xiaoqing1993/ECSE548_viterbi_decoder/README.md

# ECSE548_viterbi_decoder
The repository of final project, for codes and electric files updating and exchanging
