xiaoqing1993/ECSE548_viterbi_decoder/Final Project presentation.pptx

## (8,4,4) Viterbi Decoder

Group 2: Harsh Aurora, Adam Cavatassi, Xiaoqing Ma, Dylan Watts

## Overview

- Background
  - Encoding, transmission and decoding basics.
  - Overview of the Viterbi (8,4,4) trellis.
- Schematic and Layout
  - Design overview of key modules.
  - Implementation in schematic and layouts.
- Testing
  - Propagation Delay
  - Power
- Summary of Major Work
- Future Work
- References

## Background

Harsh Aurora

## Simplified Transmission Model

Transmitter

Encoder

Message bits + error control

[10110010]

Channel

Receiver

Decoder

Message recovery

[10X10X10]

Information Source

Output message bits

[1011]

Modulator

Transmission
pulses

Demodulator

Pulse sampling

Information Sink

Input message bits

[1011]

Gaussian Noise Corruption

[1.3, 0.1, 0.5, 1.8, -0.2, 0.5, 0.9, 0.1]

## Hamming (8,4,4) Encoder

Generator Matrix:
G= [1, 0, 0, 0, 1, 1, 1, 00, 1, 0, 0, 1, 1, 0, 10, 0, 1, 0, 1, 0, 1, 10, 0, 0, 1, 0, 1, 1, 1]
⟹ c= mG
m= m_0 m_1 m_2 m_3
c= c_0 c_1 c_2 c_3 c_4 c_5 c_6 c_7
c= m_0 m_1 m_2 m_3 p_0 p_1 p_2 p_3

- Message: m_0 m_1 m_2 m_3
- Codeword: c_0 =m_0
- c_1 =m_1
- c_2 =m_2
- c_3 =m_3
- c_4 =m_0 ⊕m_1 ⊕m_2
- c_5 =m_0 ⊕m_1 ⊕m_3
- c_6 =m_0 ⊕m_2 ⊕m_3
- c_7 =m_1 ⊕m_2 ⊕m_3

## Hamming (8,4,4) Encoder: Optimized Trellis

m_0 m_1 /m_0 m_1

m_0 m_1

00

m_2 /m_2 p_0

p_2 p_3

00

m_3 /m_3 p_1

p_2 p_3

00

- /p_2 p_3

0/00

0/00

00/00

1/11

1/11

1/11

1/11

-/00

Start

11/11

11

0/00

11

0/00

11

-/11

End

Example: m=0101

10

0/01

10

0/01

10

-/10

01/01

10/10

⟹ c=01011010

-/01

01

1/10

1/10

01

1/10

1/10

01

0/01

0/01

## Modulator and Channel

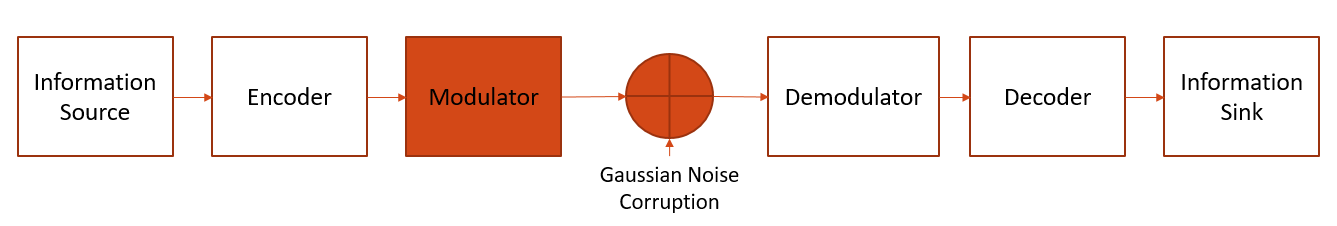
[picture p1: figure]

Channel:
- Source of noise, characterized by Signal to Noise ratio (SNR)
- SNR= (E_b)/(N_o) dB
where E_b =Energy per bit, andN_o =Noise spectral density
- Generate Gaussian distributed noise samples n= n_0 n_1 n_2 n_3 n_4 n_5 n_6 n_7
Change the variance of the Gaussian to achieve different (E_b)/(N_o)
- The noisy channel observation r is computed using
r= x+n

BPSK modulation scheme:
- 0=−1/2
- 1= 1/2
Using this scheme, Codeword c is modulated to the channel input x

## Slide 8

Hamming (8,4,4)
Decoder

Aim: Retrieve the sent message m , given the noisy channel observation r= r_0 r_1 r_2 r_3 r_4 r_5 r_6 r_7

Maximum Likelihood decoder (MLE)
- Best decoding performance!
- Generate the codebook
All possible codewords for the 2⁴ unique messages
- Compute the distance between r and each codeword
- Most probable transmitted codeword = min‖‖r −c_i ‖‖
For all c_i in the codebook
- Computationally intensive!
(≈ 383 flops)

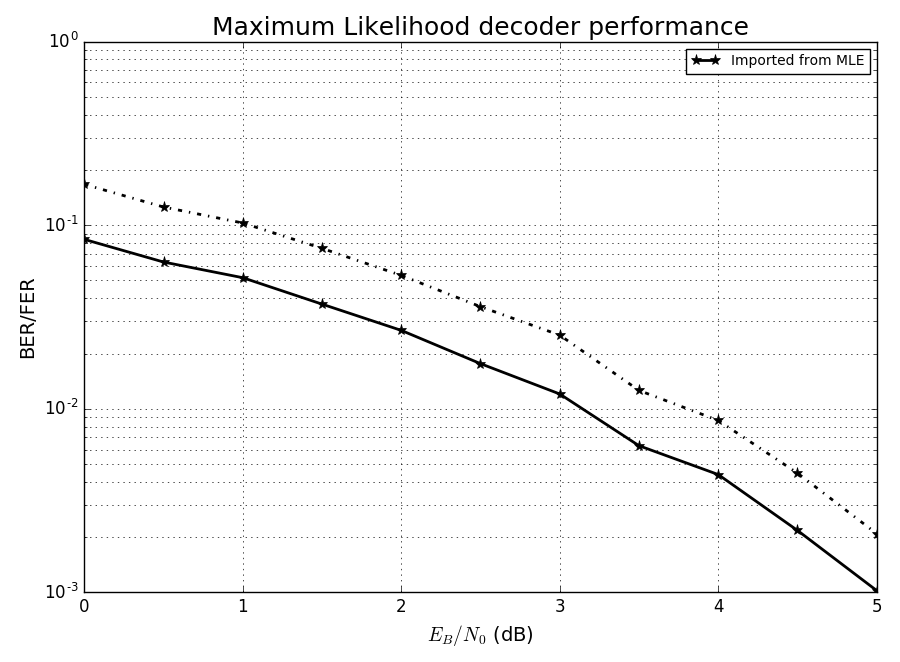
[picture p2: figure]

Figure 1: Maximum likelihood decoder performance.

## Slide 9

Hamming (8,4,4)
Decoder

Viterbi Decoder
- Same performance as the MLE decoder!
- Uses the Viterbi Algorithm on the Trellis
Calculate the shortest path of r through the Trellis
- The most likely m is extracted from the shortest path
- The modulation scheme and symmetry of the Trellis can further reduce the number of computations
(≈ 27 flops)

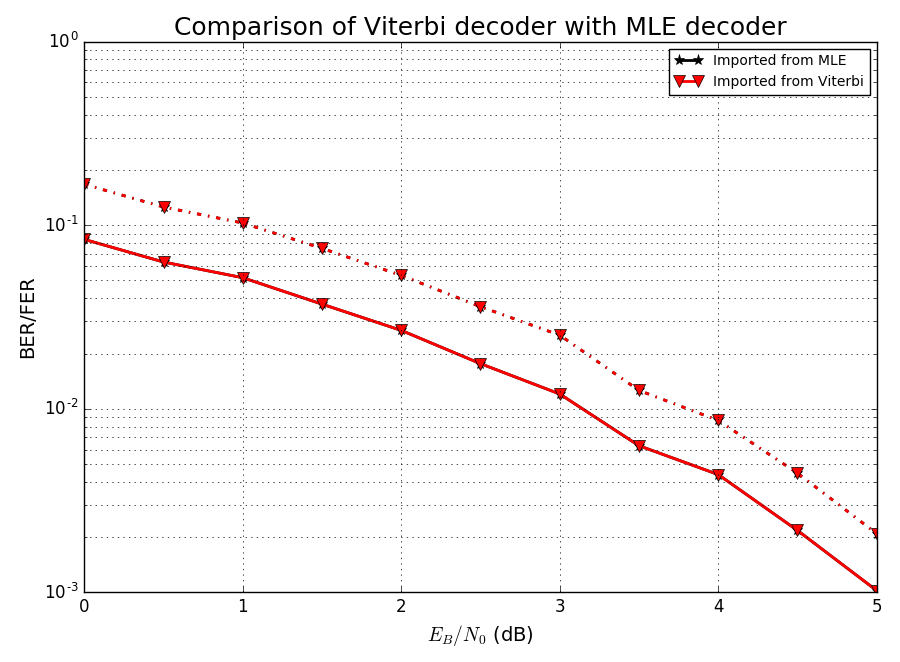
[picture p3: figure]

Figure 2: Comparison of Viterbi decoder with MLE decoder.

## Slide 10

Hamming (8,4,4)
Decoder

(−1)/2 (−1)/2

r_2 +r_4

(−1)/2 (−1)/2

r_3 +r_5

(−1)/2 (−1)/2

r_0 +r_1

1/2 1/2

0

0

1/2 1/2

0

0

1/2 1/2

r_6 +r_7

Start

0

r_2 +r_4

r_3 +r_5

0

End

r_1

1/2 (−1)/2

r_2

1/2 (−1)/2

r_3

1/2 (−1)/2

r_6

r_0

r_4

r_4

r_5

r_5

r_7

(−1)/2 1/2

r_2

(−1)/2 1/2

r_3

(−1)/2 1/2

Figure 3: Example of Hamming (8,4,4) trellis decoder.

## Slide 11

Hamming (8,4,4)
Decoder

Preparing for hardware: Use fixed point arithmetic for floating point operations!
- An approximation of a floating point number
Represent a signed floating point number f as an ( n+m ) bit binary number b= b_(n−1) ⋯b_0 b_(−1) ⋯b_(−m)
- Define the fixed point format Qn.m, where
f= −2^(n−1) b_(n−1) +2^(n−2) b_(n−2) +⋯+2^0 b_0 +2^(−1) b_(−1) +⋯+2^(−m) b_(−m)
- Fixed point arithmetic is implemented in the same manner as 2’s complement arithmetic
With the exception that an overflow/underflow is handled by saturating the result at the maximum/minimum value of the Qn.m format
- Fixed point arithmetic inherently produces quantization noise into the floating point calculations!

## Slide 12

Hamming (8,4,4)
Decoder

Obtain the performance of the Viterbi decoder for different Qn.m formats

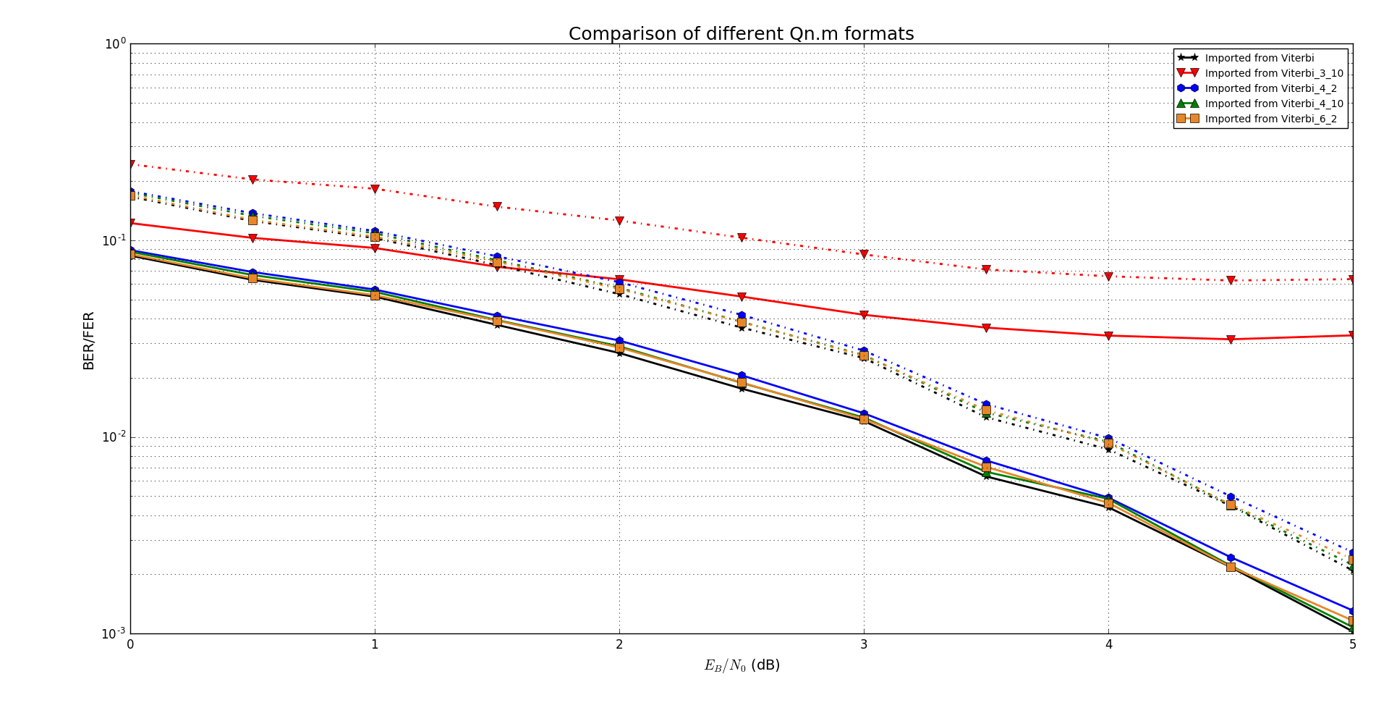
[picture p4: figure]
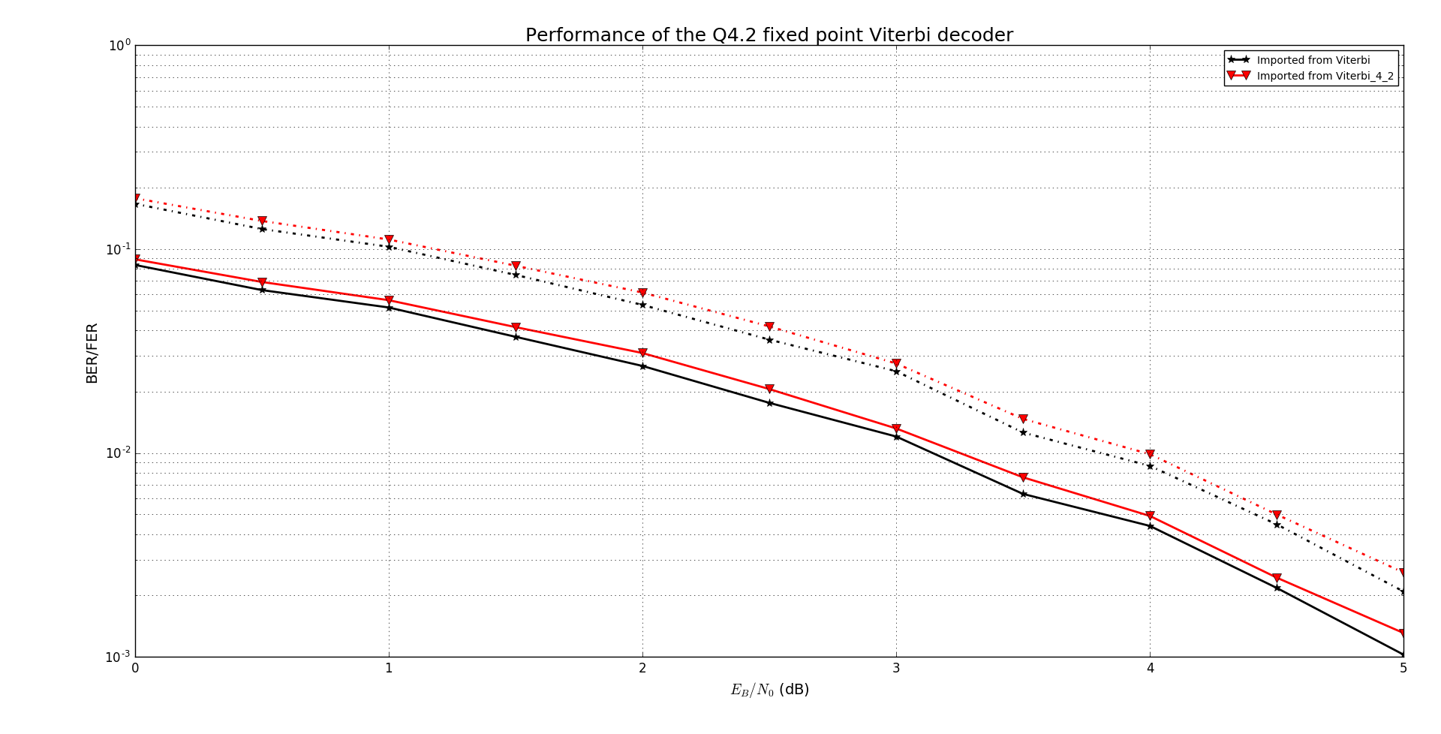
[picture p5: figure]

Figure 4: Performance of various fixed point lengths

- Q3.10
Not enough integer range
- Q4.2
Slight quantization noise
- Q4.10
Greater fractional precision reduces noise, but at high cost (8 bits in this case)
- Q6.2
Marginal improvements for greater integer range

## Schematic and Layout

Adam Cavatassi, Xiaoqing Ma

## Design Summary

- AMI 0.5μm process
- MOSIS scalable CMOS submicron design rules
- λ = 0.3μm

## Design Goals

- Schematics and layout of 2 viterbi decoder
  - Optimized for speed and power respectively
- Schematics and layouts of related modules
- DRC ERC NCC

## Required Modules

- 6-bit Adder
  - Optimization for Speed: Kogge-Stone Adder
  - Optimization for Power: Carry-Ripple Adder
- 6-bit Signed Number Comparator
- 6-bit Multiplexer

## Adder

- 6-bit signed binary addition
  - If result < -32 (10000), output result as -32
  - If result > 31 (01111), output result as 31
- Overflow
  - Check whether the result is out of range [-32, 31]

## Carry-Ripple Adder

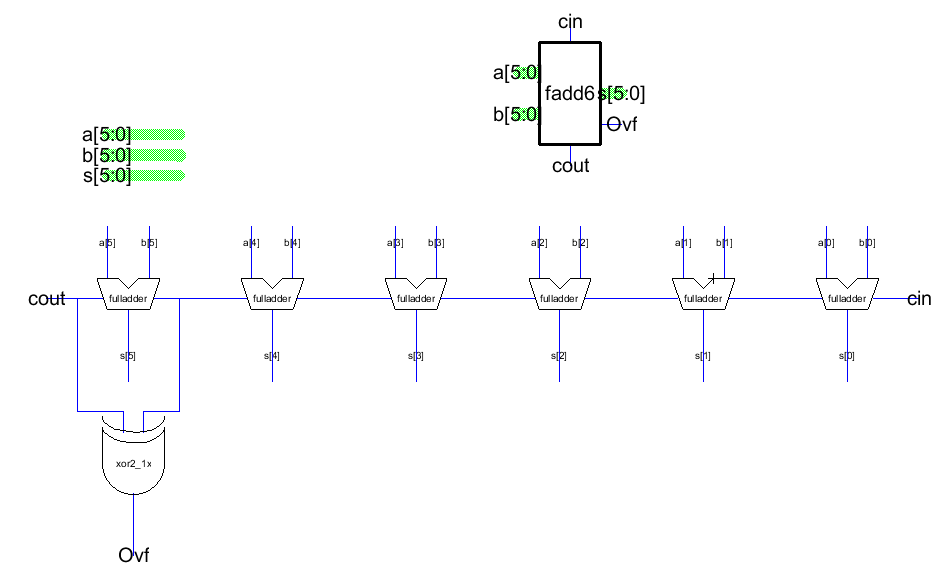
[picture p6: figure]

Figure 5: Schematic and layout of 6-bit carry-ripple adder

## Carry-Ripple Adder

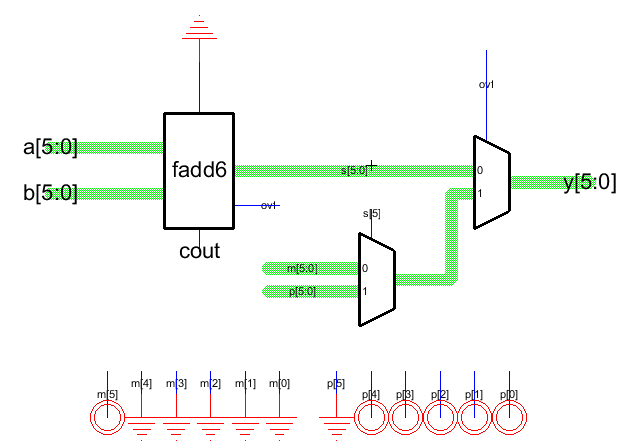
[picture p7: figure]
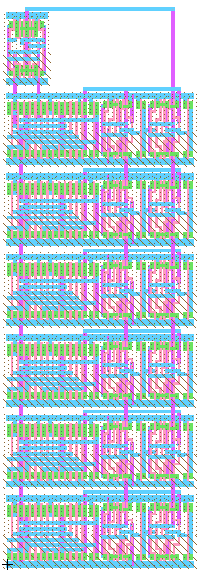
[picture p8: figure]

Figure 6: Schematic and layout of 6-bit carry-ripple adder

## Kogge-Stone (Tree Adder) – General Diagram

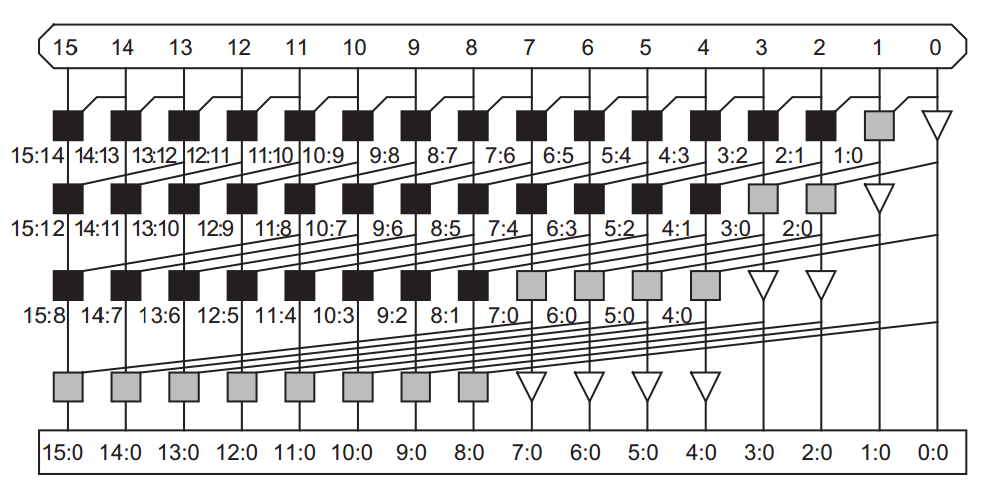
[picture p9: figure]

Figure 7 Reproduced from [1]: 16-bit kogge-stone adder PG networks

## Kogge-Stone (Tree Adder) – Bitwise PG Logic

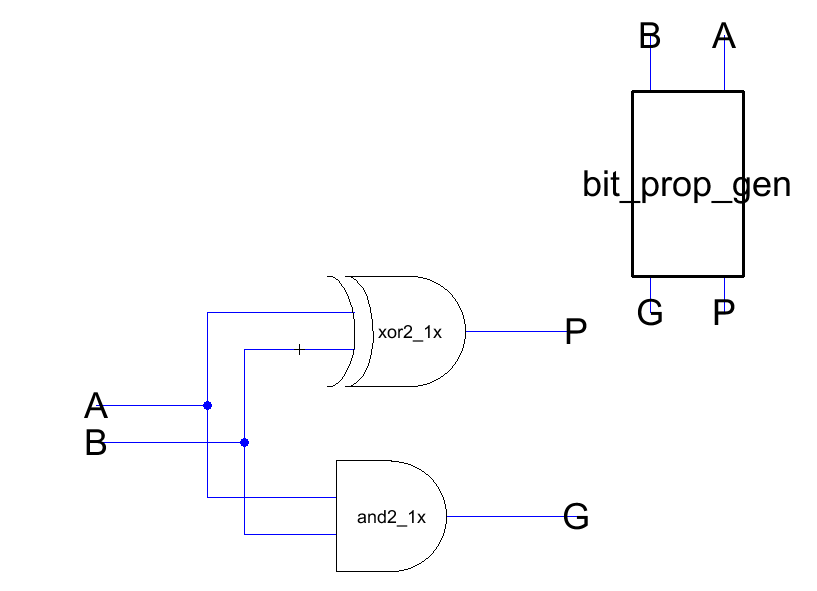
[picture p10: figure]
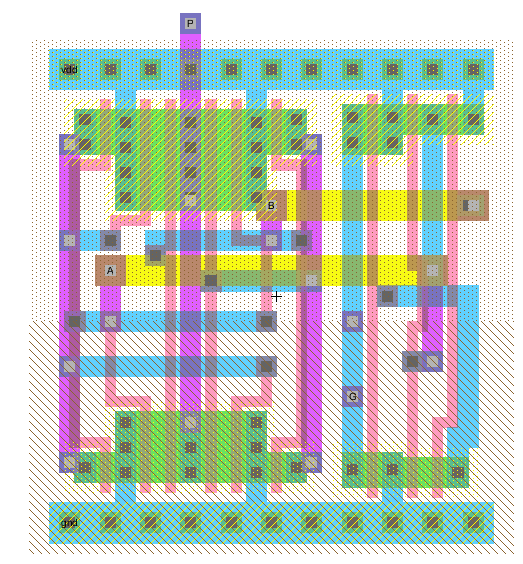
[picture p11: figure]

Figure 8: Schematic and layout of bitwise PG logic

## Kogge-Stone (Tree Adder) – Group PG Logic

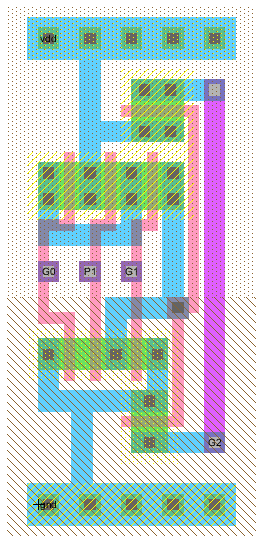
[picture p12: figure]
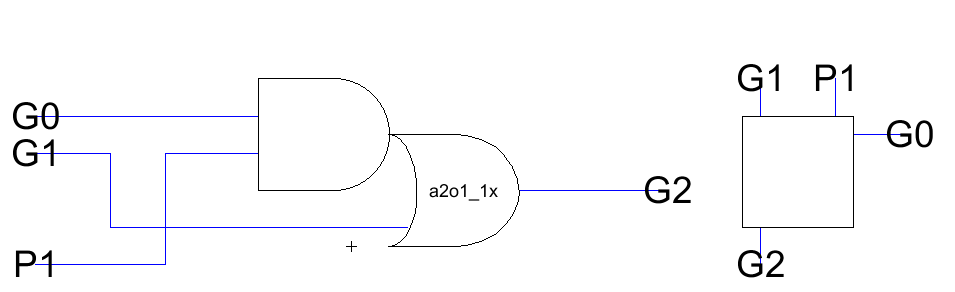
[picture p13: figure]

Figure 9: Schematic and layout of group PG logic (white cell)

## Kogge-Stone (Tree Adder) – Group PG Logic

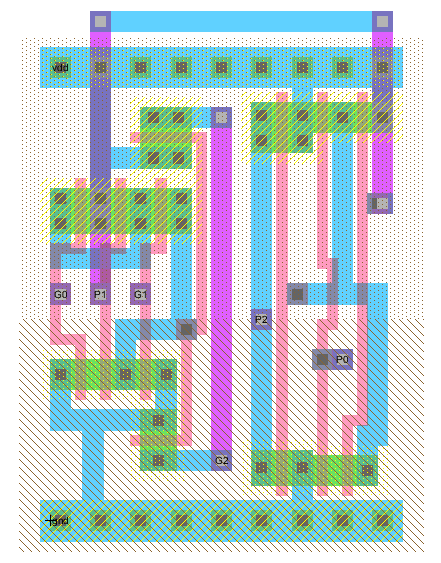
[picture p14: figure]
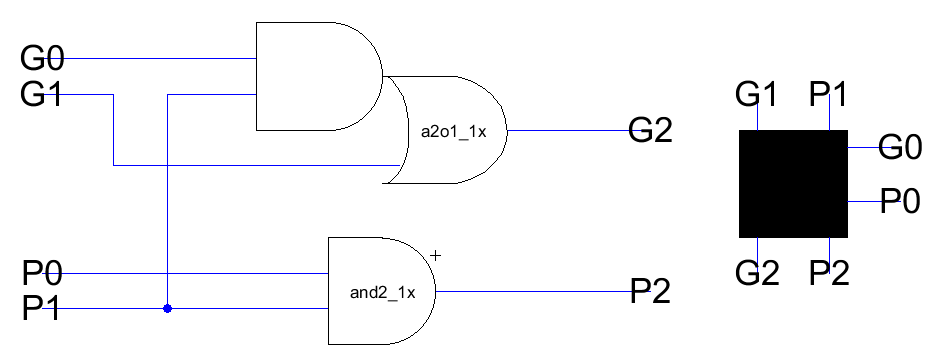
[picture p15: figure]

Figure 10: Schematic and layout of group PG logic (black cell)

## Kogge-Stone (Tree Adder) – Overall Design

Bitwise PG Logic

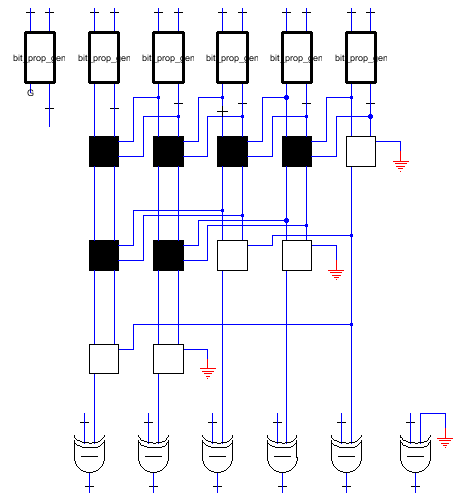
[picture p16: figure]
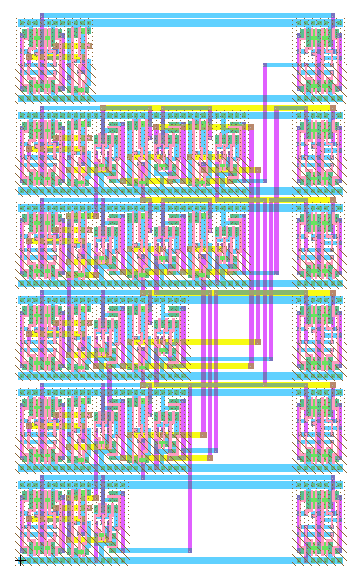
[picture p17: figure]

Rotate 90 Degrees Counterclockwise

Group PG Logic

Sum Logic

Figure 11: Schematic and layout of 6-bit kogge-stone adder

## Kogge-Stone (Tree Adder) – Overall Design

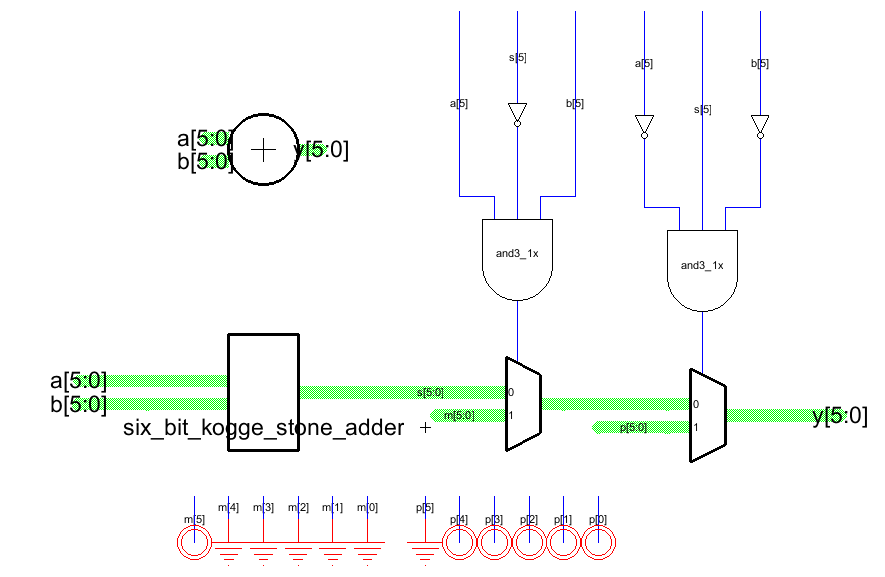
[picture p18: figure]
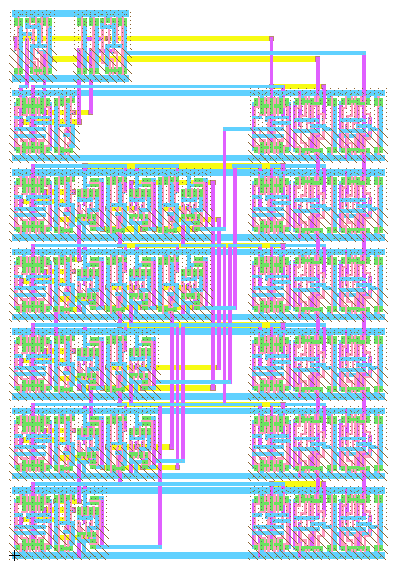
[picture p19: figure]

Figure 12: Schematic and layout of 6-bit kogge-stone adder

## Comparator - Components

- 6-bit Carry-Ripple Adder
- 6-bit Inverter
- 1-bit XOR

## Comparator – Schematic and Layout

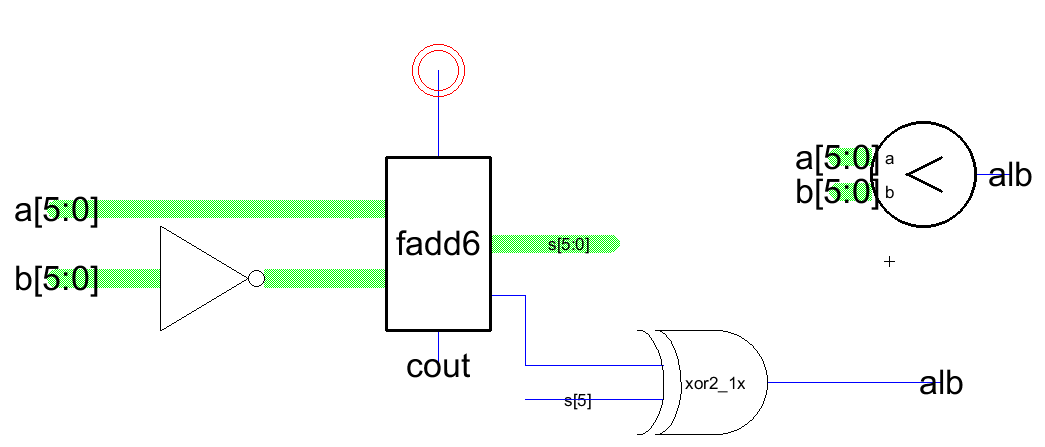
[picture p20: figure]

Figure 13: Schematic and layout of 6-bit comparator

## Miscellaneous

- 6-bit Multiplexer
  - Consist of 6 1-bit multiplexers
  - mux2_c_1x from standard cell library
- 6-bit Inverter
  - Consist of 6 1-bit inverters
  - Inv_1x from standard cell library

## Miscellaneous - 6-bit mux

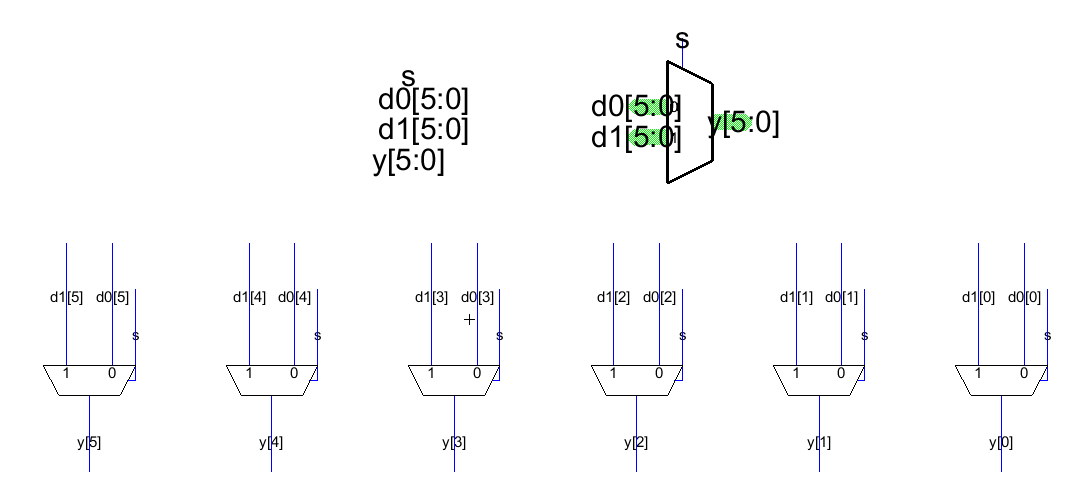
[picture p21: figure]

Figure 14: Schematic and layout of 6-bit mux

## Miscellaneous - 6-bit inverter

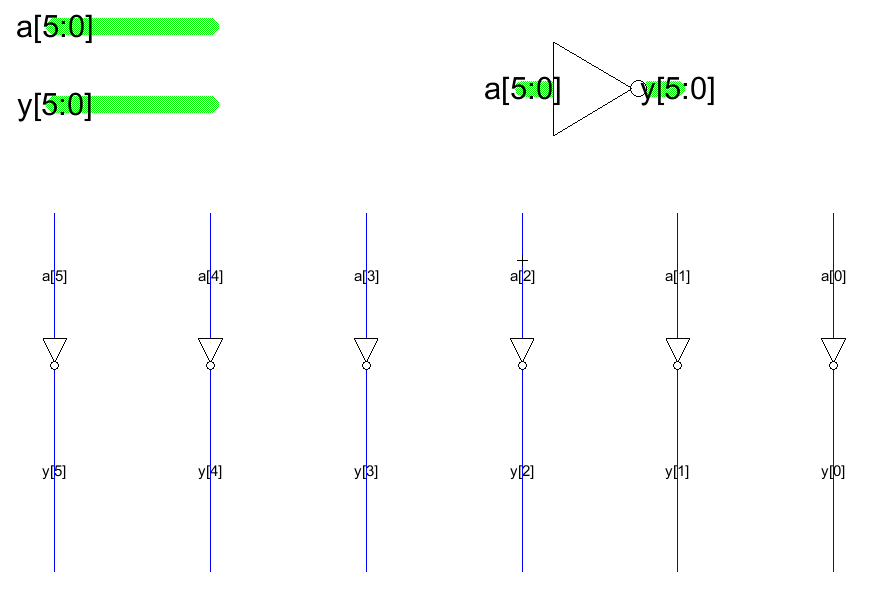
[picture p22: figure]

Figure 15: Schematic and layout of 6-bit inverter

## Overall Design – Components

Table 1: Number of individual modules

Module | Required Number
6-bit Adder | 18
6-bit Comparator | 11
6-bit Multiplexer | 10
1-bit Multiplexer | 12
1-bit Inverter | 6

## Overall Design - Schematic

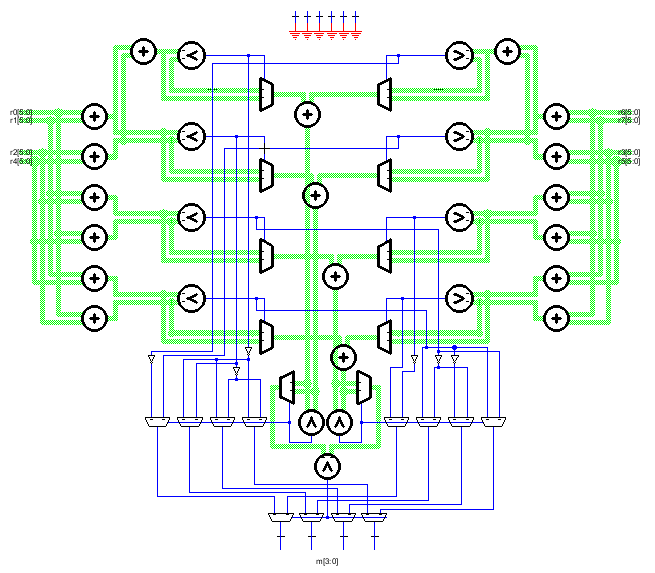
[picture p23: figure]

Figure 16: Schematic of Viterbi decoder

r0[5:0]

r1[5:0]

r7[5:0]

r6[5:0]

r4[5:0]

r2[5:0]

r3[5:0]

r5[5:0]

m[3:0]

## Overall Design – Layout (with CRA)

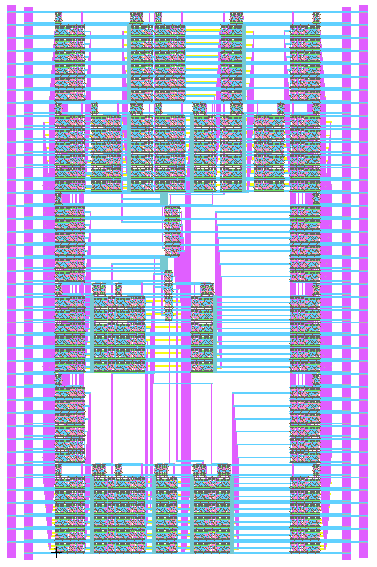
[picture p24: figure]

Figure 17: Layout of Viterbi decoder with carry-ripple adders

## Overall Design – Layout (with KSA)

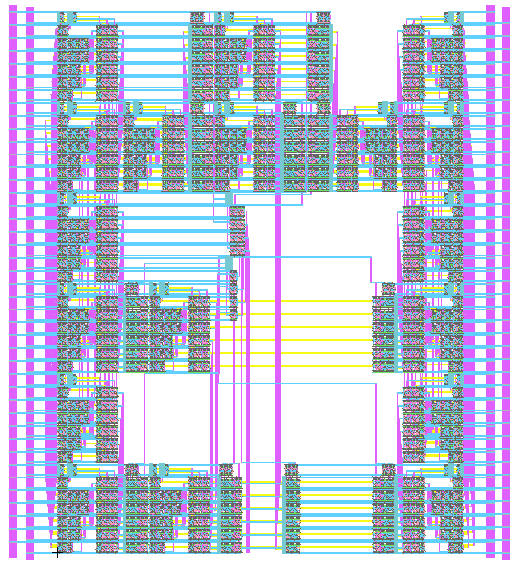
[picture p25: figure]

Figure 18: Layout of Viterbi decoder with kogge-stone adders

## Testing

Harsh Aurora, Dylan Watts

## Logic Simulators

Harsh Aurora

## ModelSim

Functional verification of hardware designed in Electric
  - Create a fixed point Viterbi Decoder in Verilog using ideal hardware components
  - Extract noisy channel observations in Q4.2 format and the expected output from C code
  - Build a testbench around the Verilog decoder implementation
Using the extracted data from the C code
  - Allow for incremental testing of hardware
Substitute ideal Verilog components with Verilog code extracted from Electric

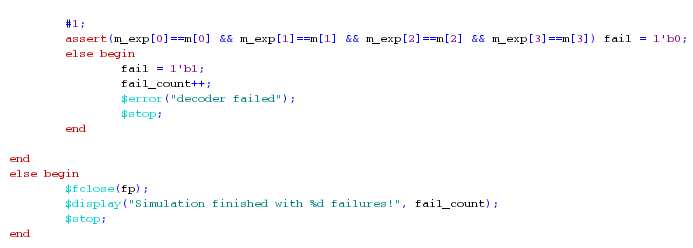
[picture p26: figure]

Figure 19: Example of functional testing via ModelSim

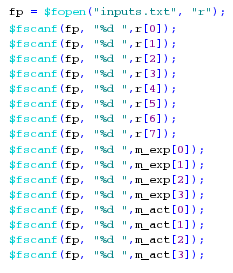
[picture p27: figure]

## Electric

- All schematics and layouts passed DRC, ERC, NCC, as well as functionality testing through ModelSim and IRSIM

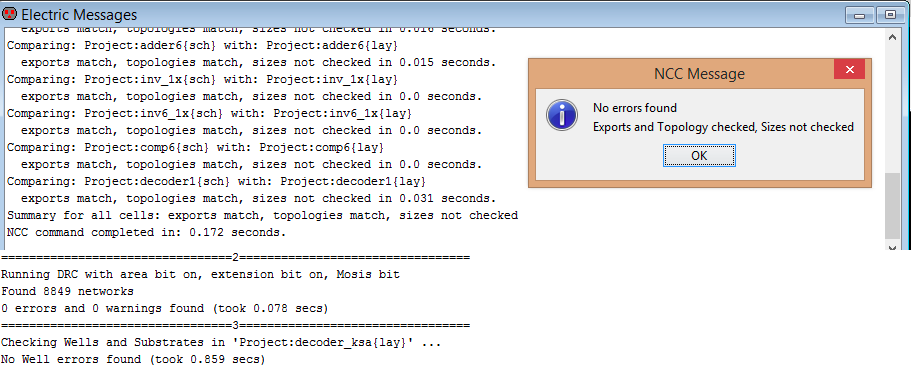
[picture p28: figure]

Figure 20: Demonstration of passing design checks for both decoder implementations.

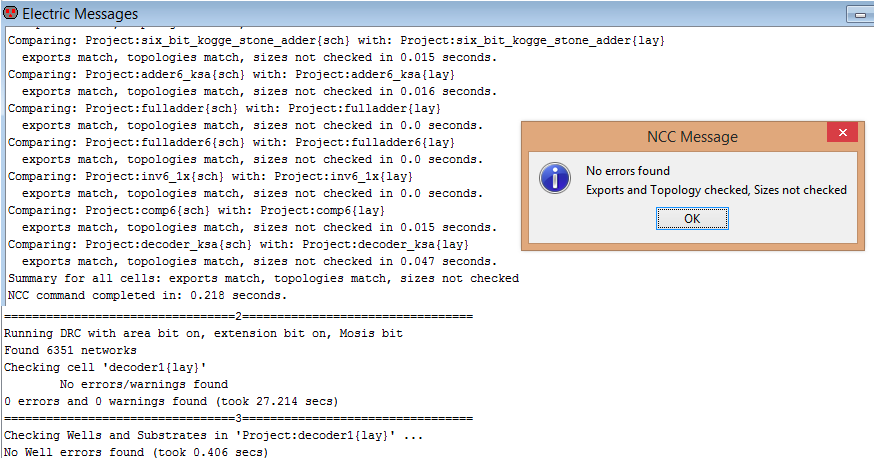
[picture p29: figure]

## Circuit Simulators

Dylan Watts

## Challenges and Assumptions

Challenges:
  - Circuit complexity – overall not a large circuit, but a lot of inputs.
  - Licensing!!!!
Assumptions:
  1. Assume uniform distribution of input vectors – not true in general, but conservative.
  2. Neglect static power dissipation due to size of process, assume switching power is dominant factor.
  3. For the purposes of power calculation, each module drives a “characteristic capacitive load” which is a weighted average of interconnect and input capacitance.
  4. Delay of all outputs equal to the largest propagation delay for multi-output modules.
  5. False paths are neglected.
  6. Interconnect is neglected
  7. The transistor are uniformly sized using the “1x” ratio (between 1.5-2.5).

## Power Analysis

8 inputs of 6 bits each – Possible combinations are 2⁴⁸ = 281 trillion!
  - Impractical to test all possible combinations of inputs and outputs in SPICE.
Can use a bounding approach.
  - Test all possible combinations of input vectors for individual modules and observe the power statistics
  - Min/avg/max power consumption.
Multiply individual statistics by the number of modules in the circuit.
By assuming every component in circuit is operating at the worst case input, can obtain a very conservative estimate of worst-case power consumption for the overall circuit.

## Power Analysis

Ripple-Carry and Kogge-Stone adder/comparator each take two six-bit input vectors:
  - 2¹² = 4096 possible input combinations.
2-input MUX takes two six-bit input vectors, 1 select line:
  - Since it’s one or the other, can simplify to 1 six-bit input vector and one select line.
  - 2⁷ = 128 possible input combinations.
Can generate these inputs intelligently by adding voltage pulses oscillating at specific frequencies:

## Power Analysis

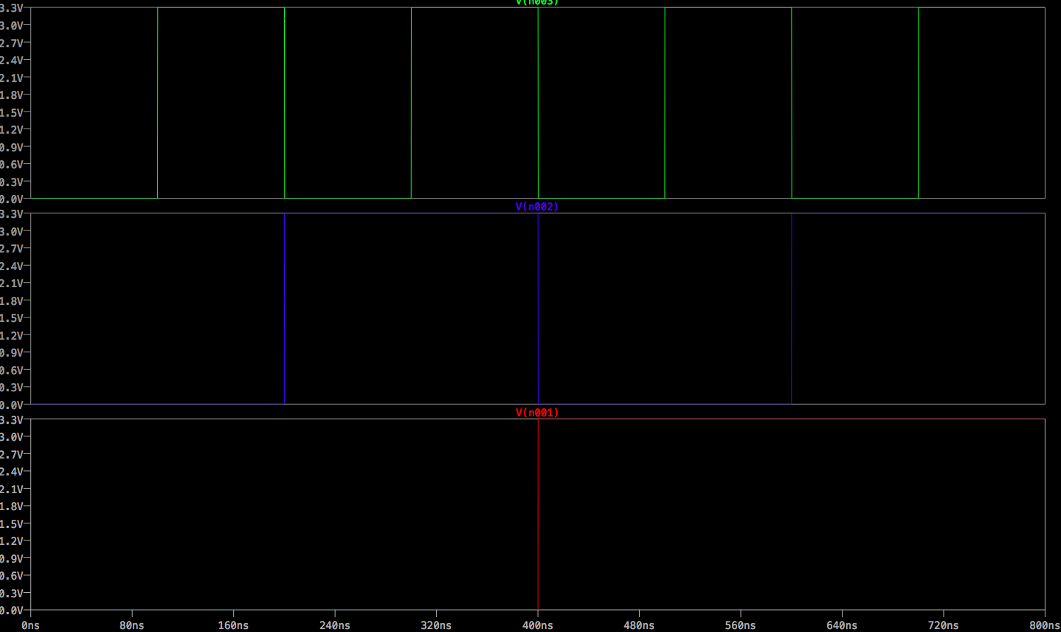
[picture p30: figure]

Figure 21: Addition of periodic voltages to obtain desired waveform

## Power Analysis

- Since each circuit is being evaluated independently, need to provide a “characteristic load”.
- If interconnect is neglected, load is a combination of output capacitance and input capacitance of the connected module.
  - Obtain a weighted average of input capacitance for all submodules

Table 2: Average and Maximum load capacitances/bit on each module.

## Power Simulation – adder6_KSA_avg

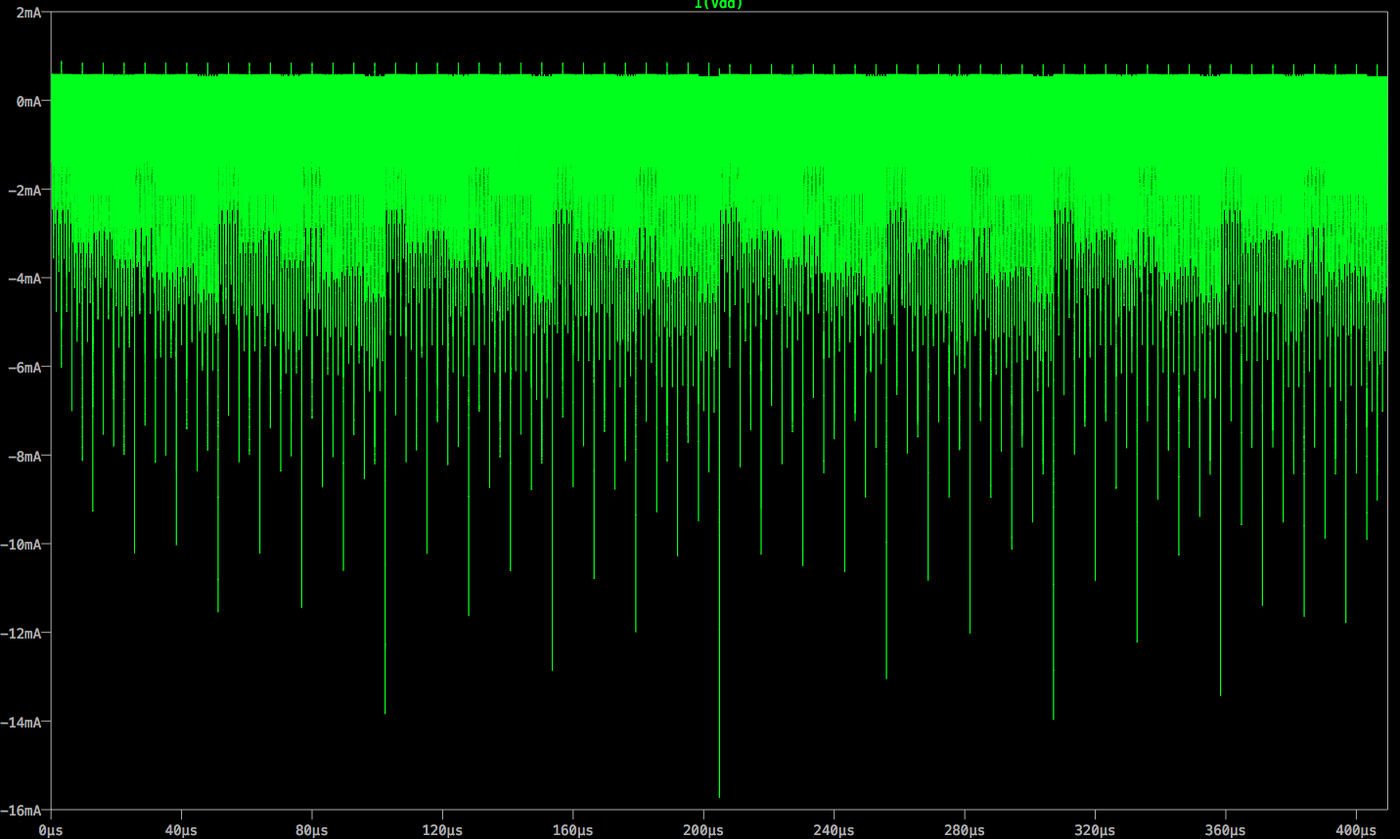
[picture p31: figure]

Figure 22: Spice simulation for all 4096 possible combinations

## Module Results – Average/Max Load

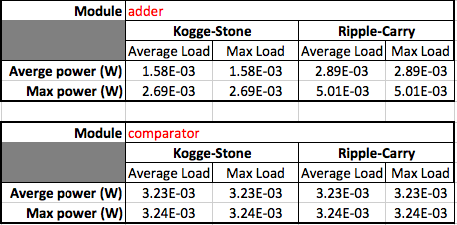
[picture p32: figure]

Table 3: Power usage of various sub-modules

Notes: Using netlists generated by electric and LTSPICE, an open source alternative to PSPICE and HSPICE we can analyze the power consumption of the four different modules.

## Circuit Results – Average/Max Load

Table 4: Power usage of the two decoder implementations under various loading conditions

## Propagation Delay: Static Timing Analysis

- Can convert into a network of nodes and directed edges. The node weight corresponds to the delay of the component and the edge weight corresponds to the delay of the interconnect

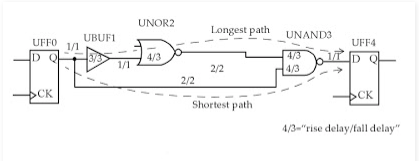
[picture p33: figure]

Figure 23 Reproduced from [2]: conversion of logic paths into edge-weighted graph for calculation of shortest and longest path

Tools which can perform static timing analysis Cadence/Synopsis
Unfortunately had to make due with what was available – had to get creative.

## Static Timing Analysis

Gate Delay

Component Delay

Interconnect Delay

Circuit Delay

1. Delay of individual gates using built in RC timing simulator. Obtained using Electric and IRSIM.
2. Wire and gate delay combined into a node/edge weighted directed graph. Shortest/longest path algorithms run on Matlab.
3. Delay of wires connecting individual gates using a 4 segment π -model. Obtained using Electric ‘Layout’ and LTSPICE.
4. Wire and component delay combined into a node/edge weighted directed graph. Shortest/longest path algorithms run on Matlab.

## Static Timing Analysis

Gate Delay

1. Delay of individual gates using built in RC timing simulator. Obtained using Electric and IRSIM.
2. Wire and gate delay combined into a node/edge weighted directed graph. Shortest/longest path algorithms run on Matlab.
3. Delay of wires connecting individual gates using a 4 segment π -model. Obtained using Electric ‘Layout’ and LTSPICE.
4. Wire and component delay combined into a node/edge weighted directed graph. Shortest/longest path algorithms run on Matlab.

Component Delay

Interconnect Delay

Circuit Delay

## Individual Gate Delays

- Typically provided by manufacturer
- Can use IRSIM, a simulation program which uses rectangular waveforms, but takes into account an RC delay model

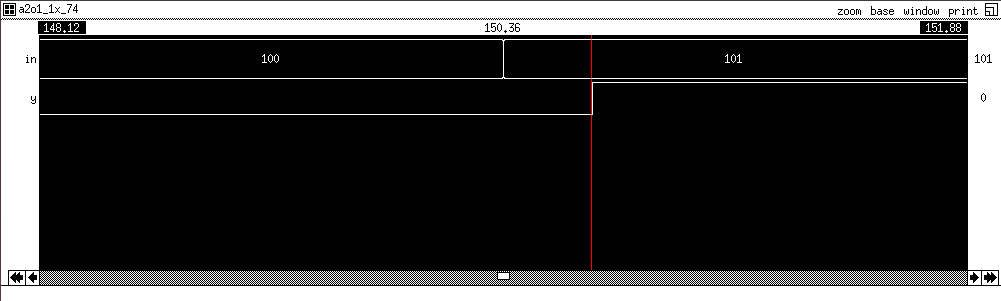
[picture p34: figure]

Figure 24: Propagation delay for a typical gate measured in IRSIM.

## Slide 52

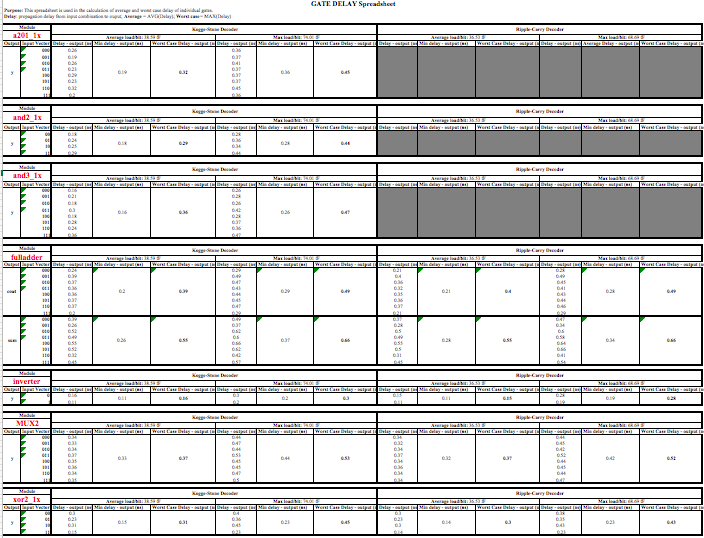
[picture p35: figure]

Figure 25: Gate delays for all main foundational gates.

## Component Delay

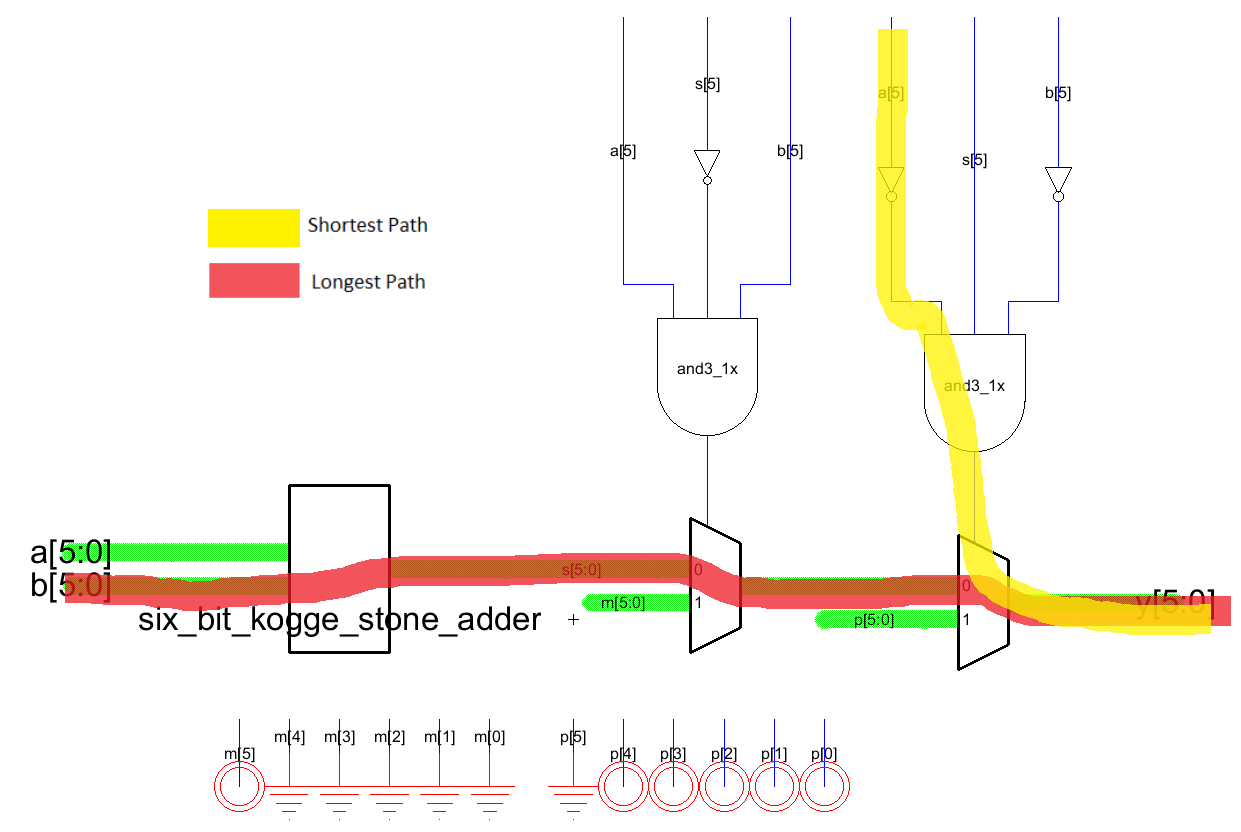
[picture p36: figure]

Figure 25: Visual detection of longest ands shortest path

- With the gate delay and neglecting wire delay can determine longest/shortest path through various submodules, gradually moving up the hierarchy
- Example: adder_ksa
- Longest Path:
  - Largest delay: adder6_ksa
  - 2 x Largest delay: MUX6
- Shortest Path:
  - Shortest path: inverter
  - Shortest path: and3
  - Shortest path:MUX6

## Component Delay

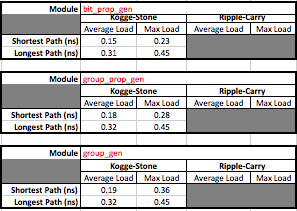
[picture p37: figure]
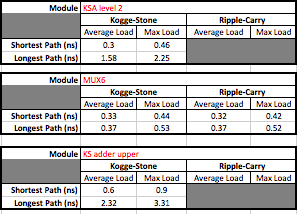
[picture p38: figure]

Table 6: Delays for various sub-modules under various loading conditions.

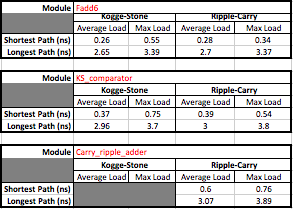
[picture p39: figure]

## Circuit Delay

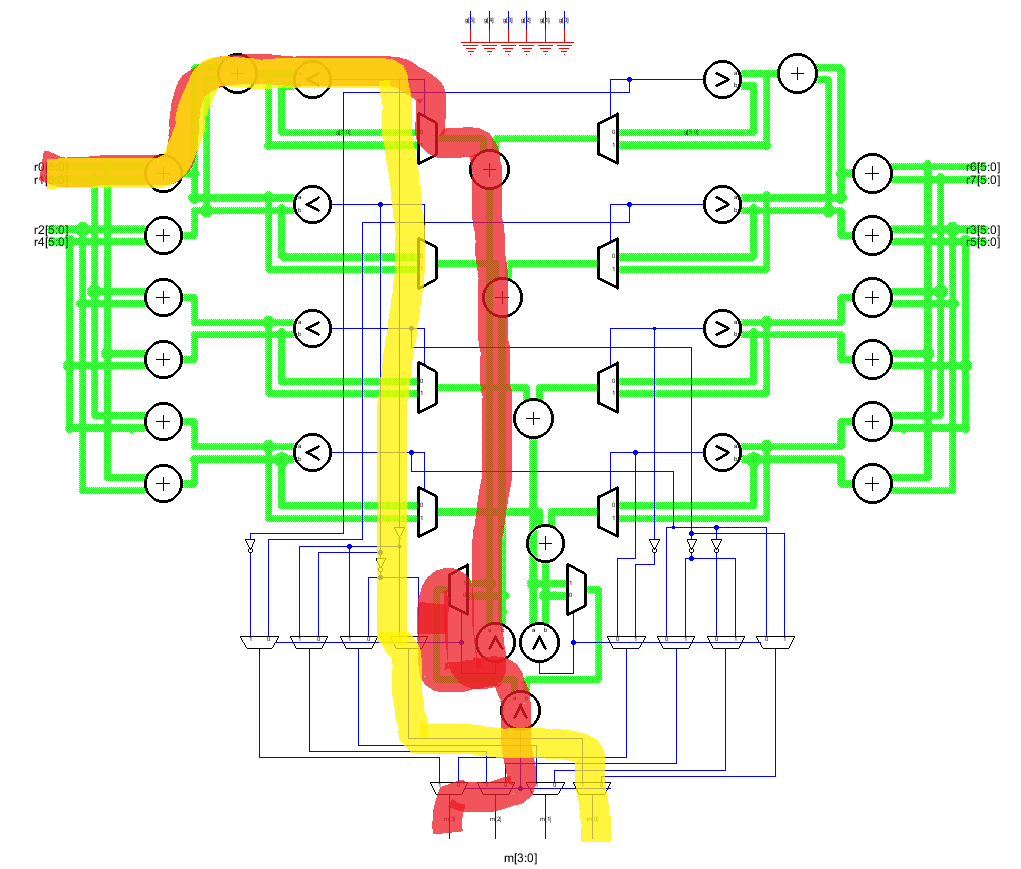
[picture p40: figure]

Figure 26: Visual detection of longest and shortest path.

- Once all submodules have been calculated for each circuit implementation, can determine the overall delay of the circuit:
- Longest Path:
  - 3 x Largest delay: adder_ksa
  - 3 x Largest delay: comparator
  - 2 x Largest Delay: MUX6
  - Largest delay: MUX2
- Shortest Path:
  - 3 x shortest delay: adder_ksa
  - Shortest delay: comparator
  - Shortest delay: inverter
  - 2 x Shortest delay: MUX2

## Circuit Delay

Table 7: Delay of decoder implementations under various loading conditions.

## Verify with Typical Cases - ISIM

Can verify the validity of the bounds by running a full simulation of certain test vectors on IRSIM. As a byproduct, we can determine whether the circuit functions correctly!

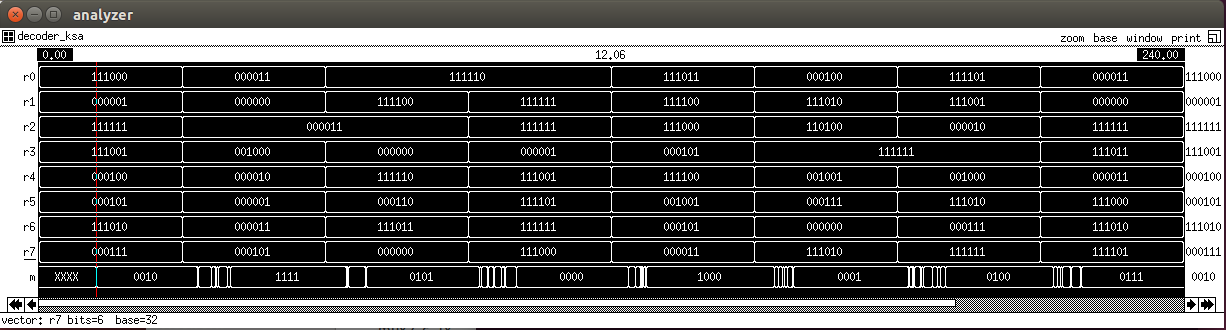
[picture p41: figure]

Figure 27: Visualization of propagation delay and correct functionality of the circuit using IRSIM.

## Circuit Delay

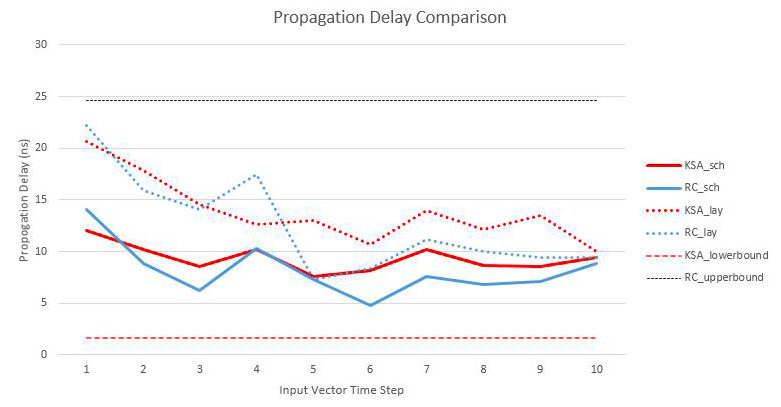
[picture p42: figure]

## Results Summary

- Design Implementation:
  - Both designs pass all relevant design checks (DRC, ERC,NCC)
- Functionality:
  - Both implementations function accordingly in both ModelSim and IRSIM.
- Power Usage:
  - The Kogge-Stone adder uses less power. (Topic of further investigation)
- Propagation Delay:
  - In 3 out of 4 cases Kogge-Stone is faster.

Table 8: Comparison of two decoder implementations.

## Summary of Major Work

## Summary of Major Work

1. Design of a custom architecture and data structure for the optimized encoding and decoding of (8,4,4) codewords.
2. Implementation of design of two different implementations, one optimized for speed and the other power, on both Schematic and Layout.
3. Full functional verification on ModelSim and partial verification on IRSIM.
4. Fulfillment of all design checks (DRC, ERC, NCC).
5. Exhaustive testing of decoder implementations under various loading regimens.
6. Determination of an upper and lower bound for power consumption and propagation delay.
7. Partial validation of upper and lower bound via IRSIM simulation.

## Future Work

## Future Work

- Interconnect Delay
  - Important to include – can account for up to 80% of overall delay of a circuit in modern processes [1].
  - 4 segment π -model is sufficient to characterize the wire.
- Comparator
  - Replace the fulladder in the comparator with a Kogge-Stone adder. Should increase speed and reduce critical path.
- Transistor Sizing
  - Size the transistors to provide ideal ratio for propagation delay.

## References

## Slide 65

[1] CoN.West ad D.M. Harris, CMOS VLSI Design A Circuits and Systems Perspective, 4th ed., Addison-Wesley, 2011.
[2] VLSI Co (http://www.vlsi-expert.com/2011/03/static-timing-analysis-sta-basic-timing.html)ncepts, and online center for all who have interest in the Semiconductor industry; http (http://www.vlsi-expert.com/2011/03/static-timing-analysis-sta-basic-timing.html):// (http://www.vlsi-expert.com/2011/03/static-timing-analysis-sta-basic-timing.html)www.vlsi-expert.com/2011/03/static-timing-analysis-sta-basic-timing.html, Wed.March 9 2011.
