xiaoqing1993/ECSE548_viterbi_decoder/Schematic Diagrams/Electric Schematics/Schematics.docx

A201_1x

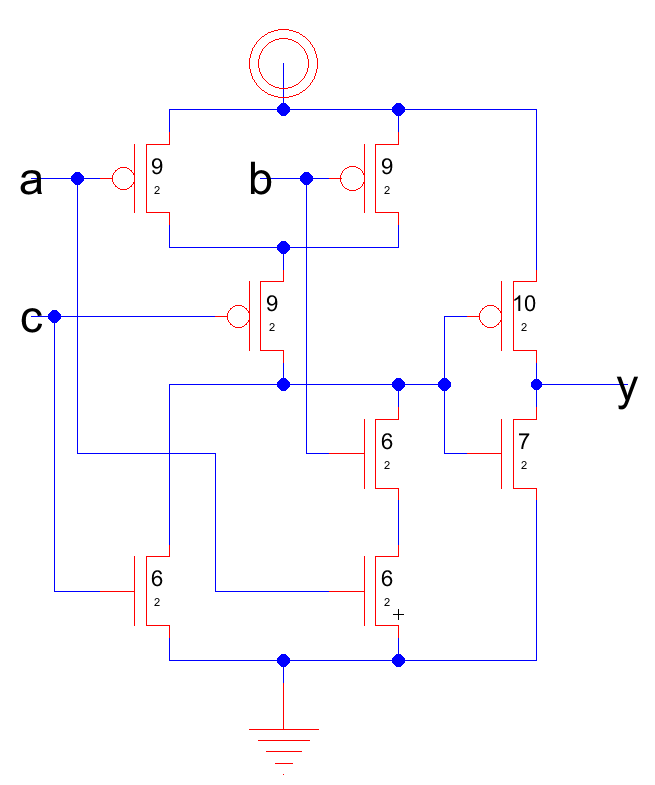
[picture p51: figure]

And2_1x

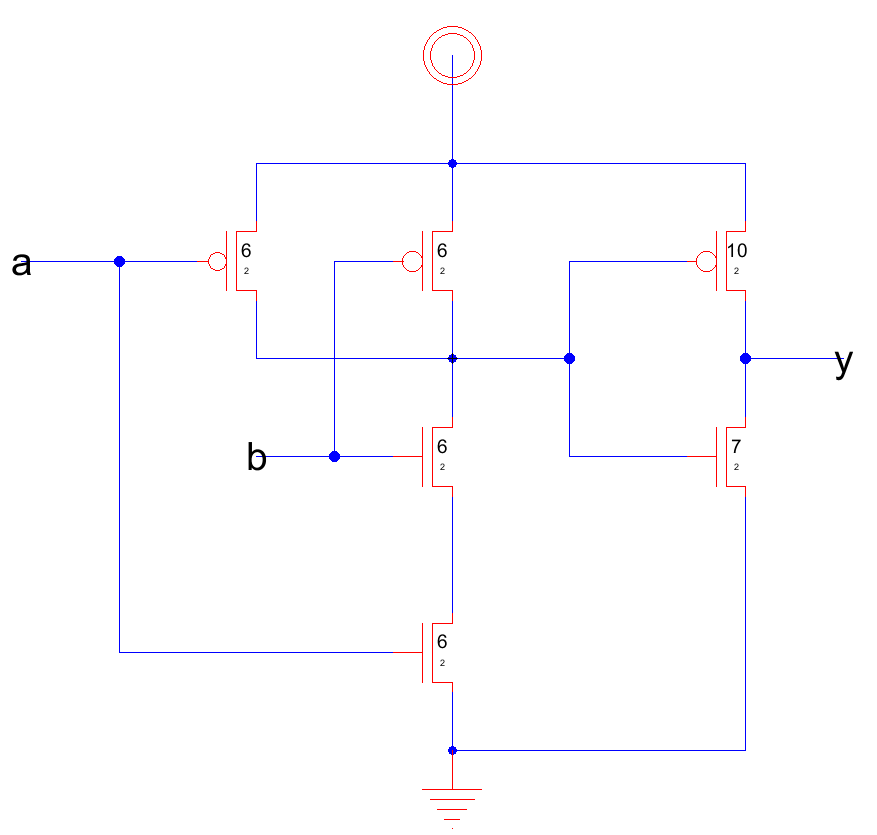
[picture p52: figure]

And3_1x

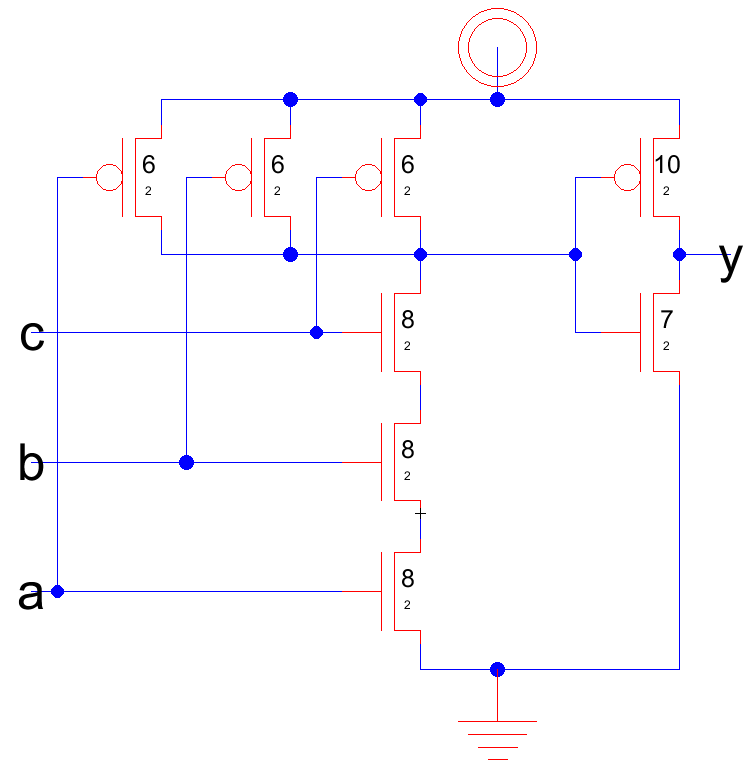
[picture p53: figure]

Bit_prop_gen

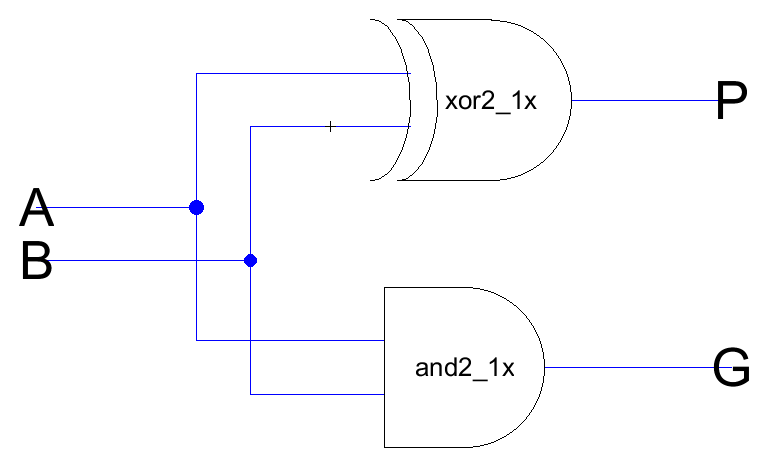
[picture p54: figure]

Carry_ripple_adder

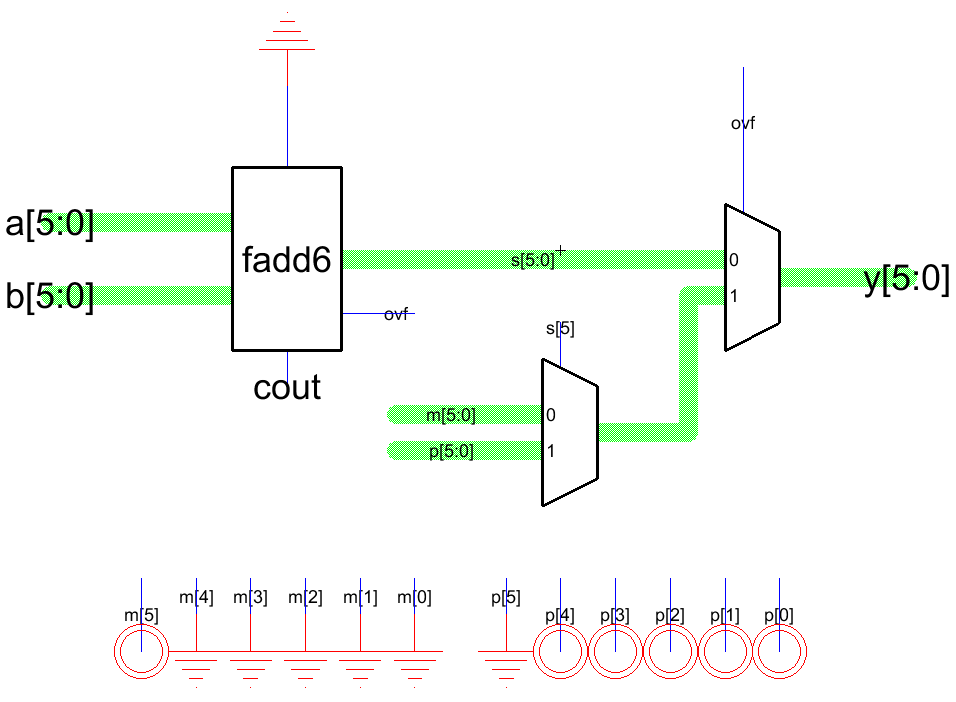
[picture p55: figure]

Fadd6

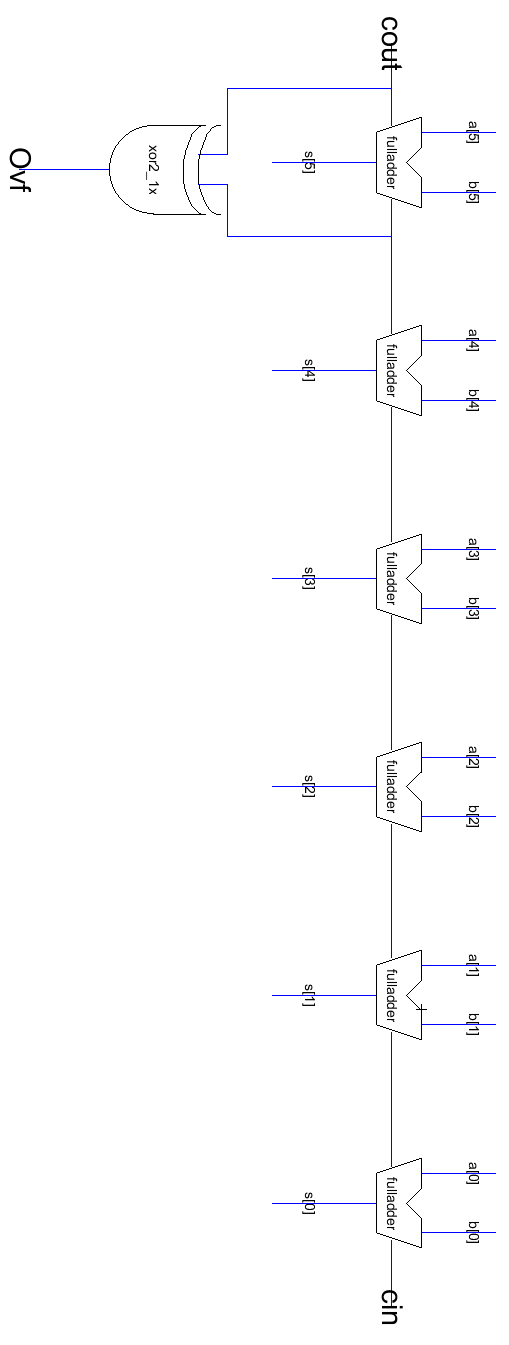
[picture p56: figure]

Fulladder

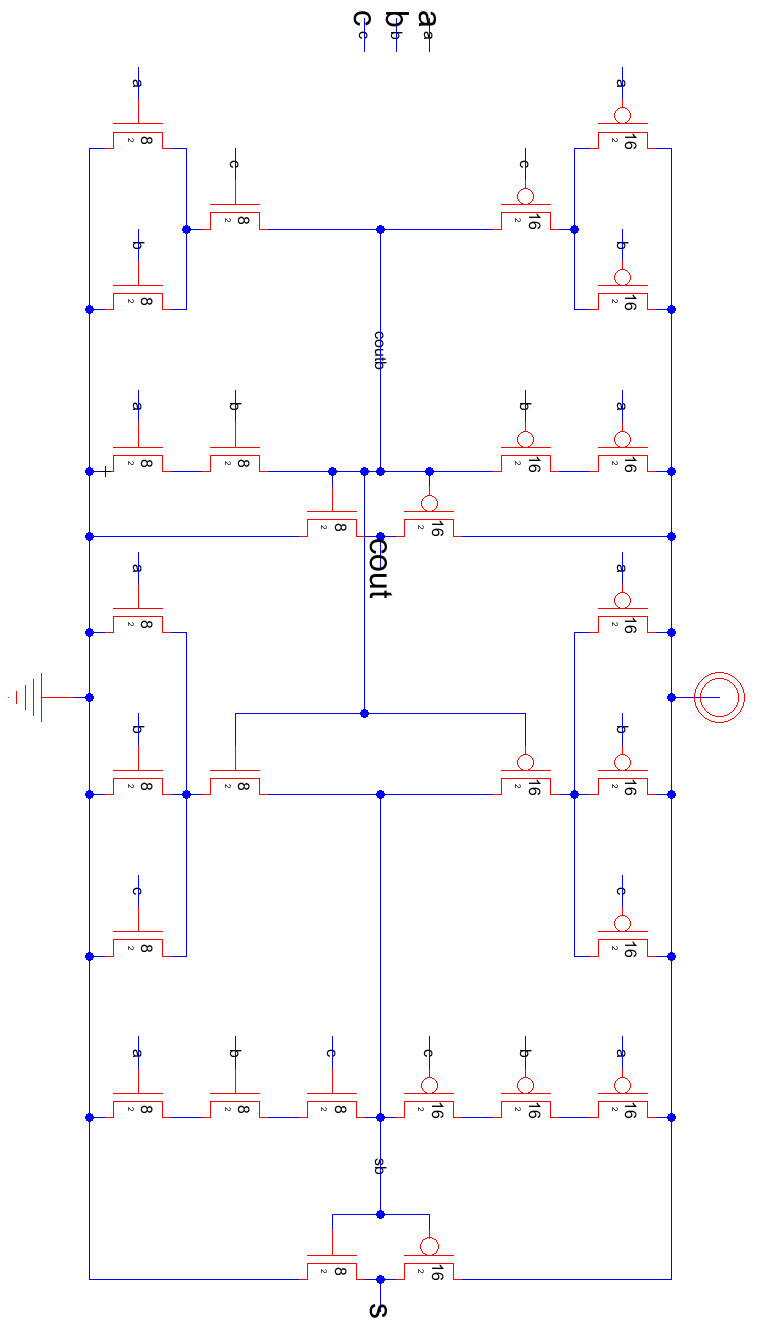
[picture p57: figure]

Group_gen

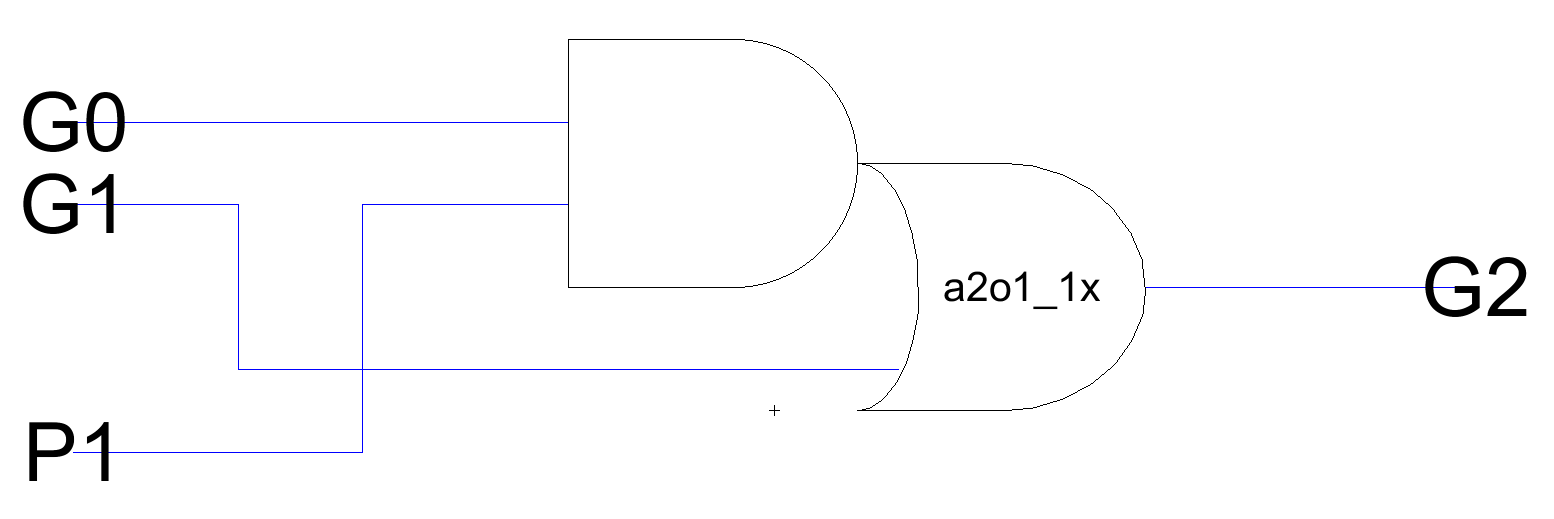
[picture p58: figure]

Groupd_prop_gen

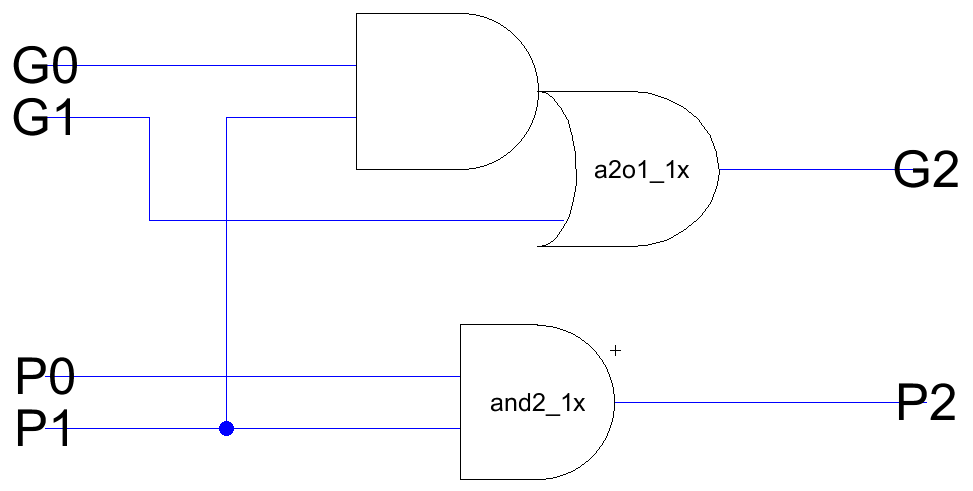
[picture p59: figure]

Inverter

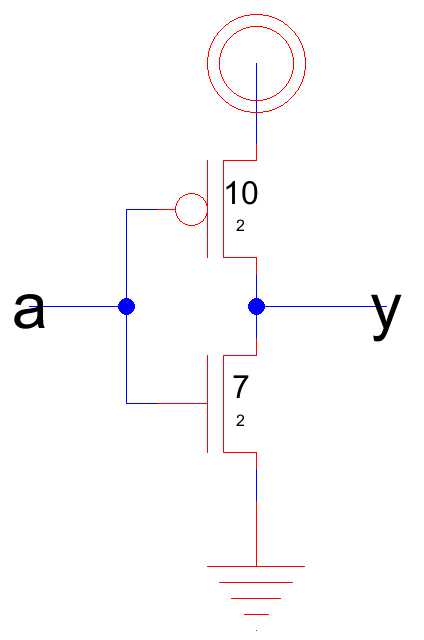
[picture p60: figure]

KS adder upper

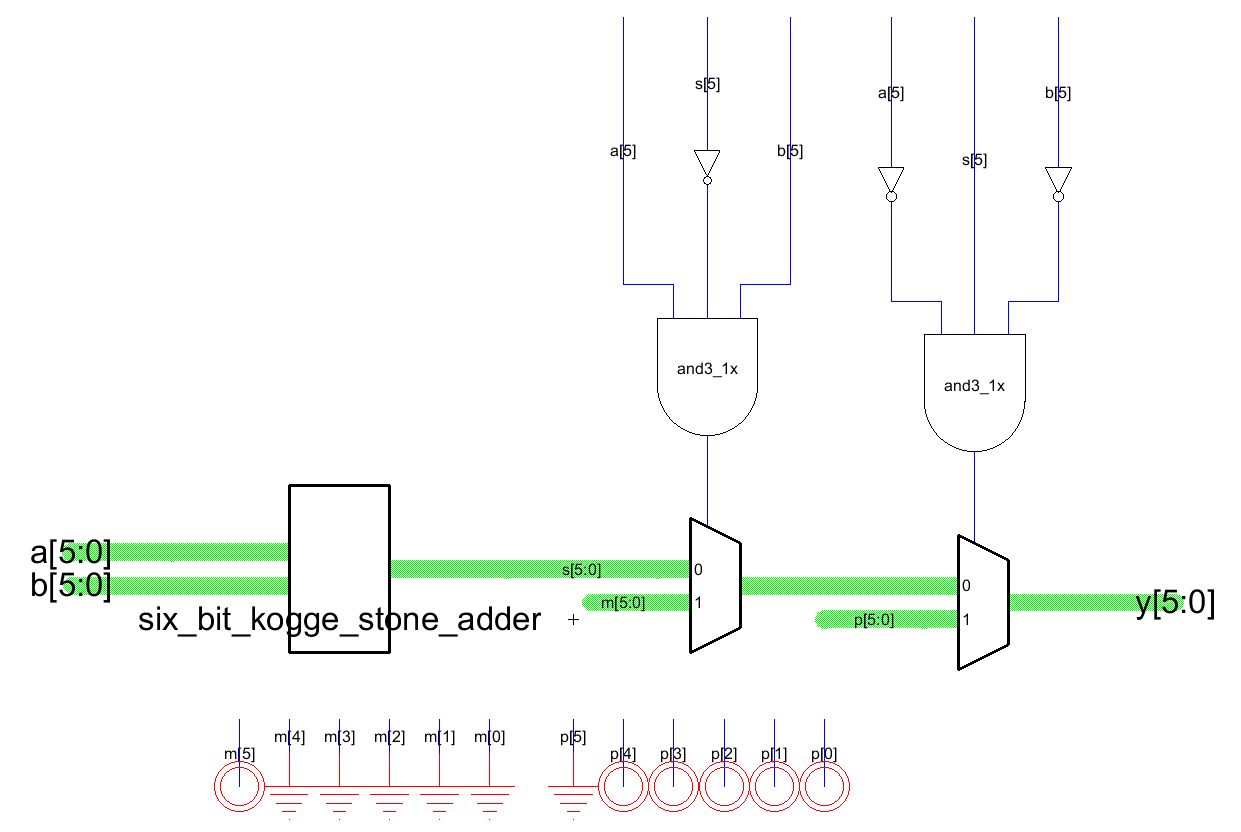
[picture p61: figure]

KS_comparator

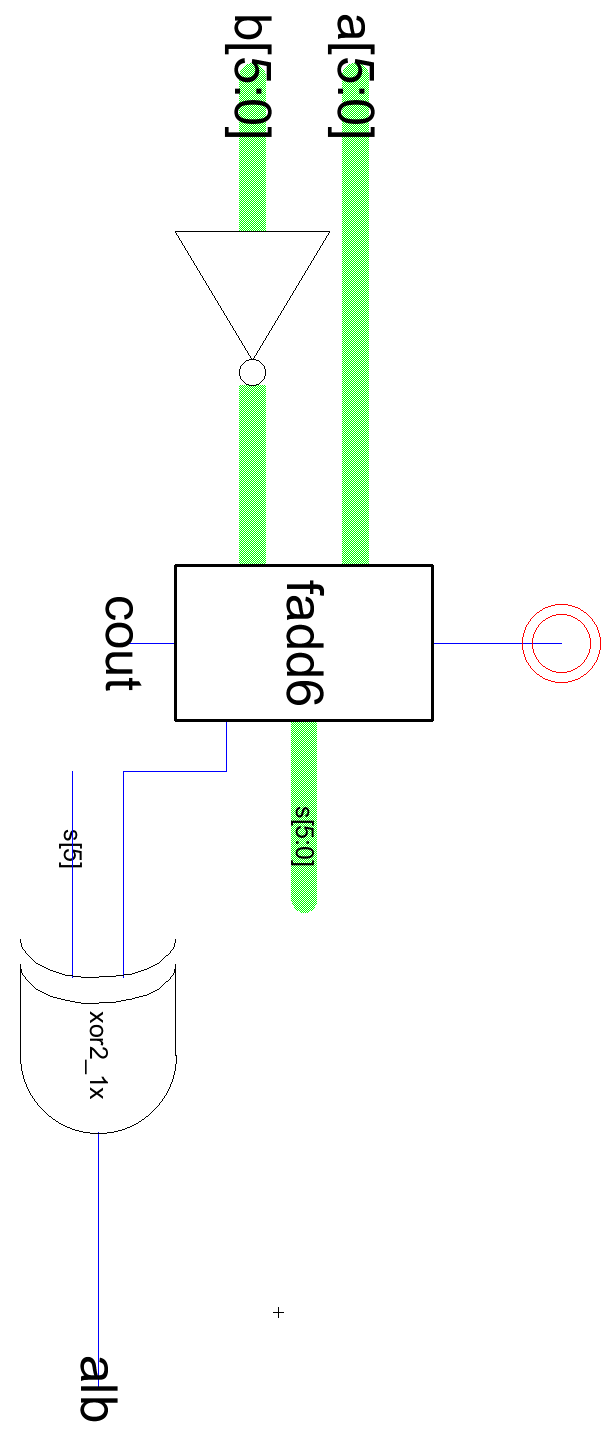
[picture p62: figure]

KSA level 2

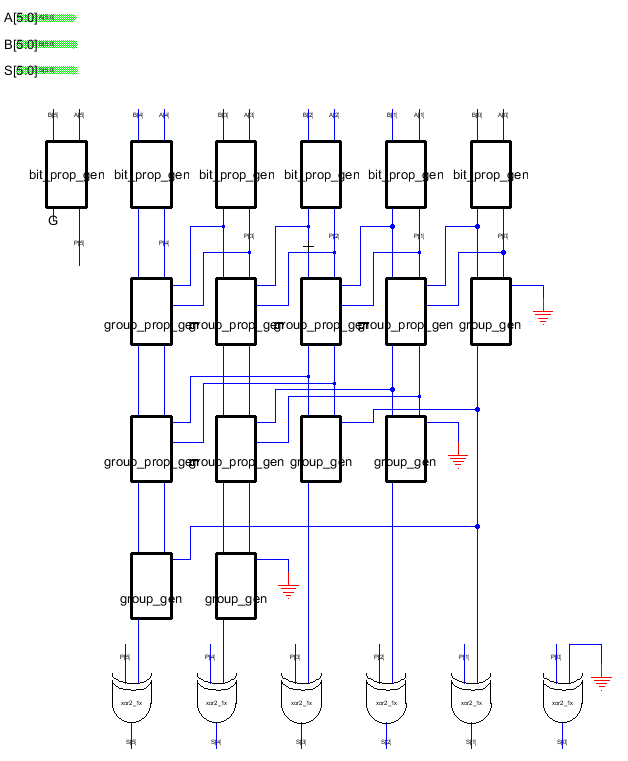
[picture p63: figure]

KSA top level

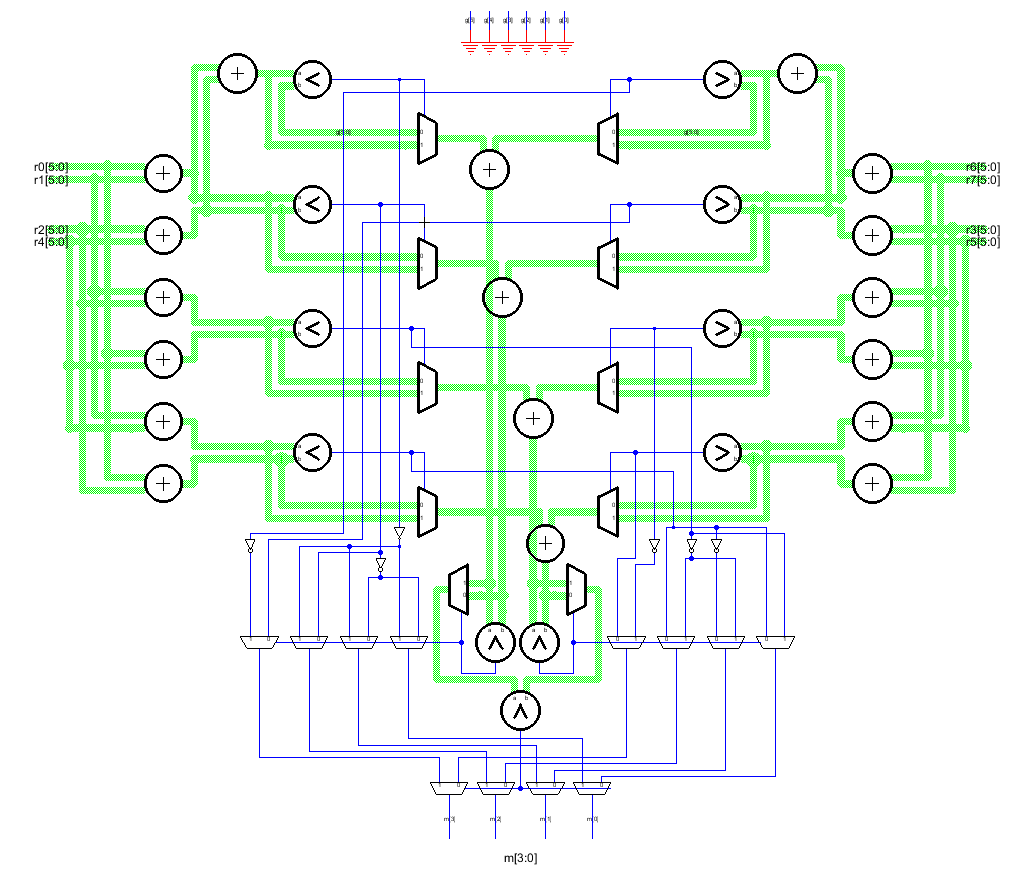
[picture p64: figure]

Carry Ripple top level

MUX2

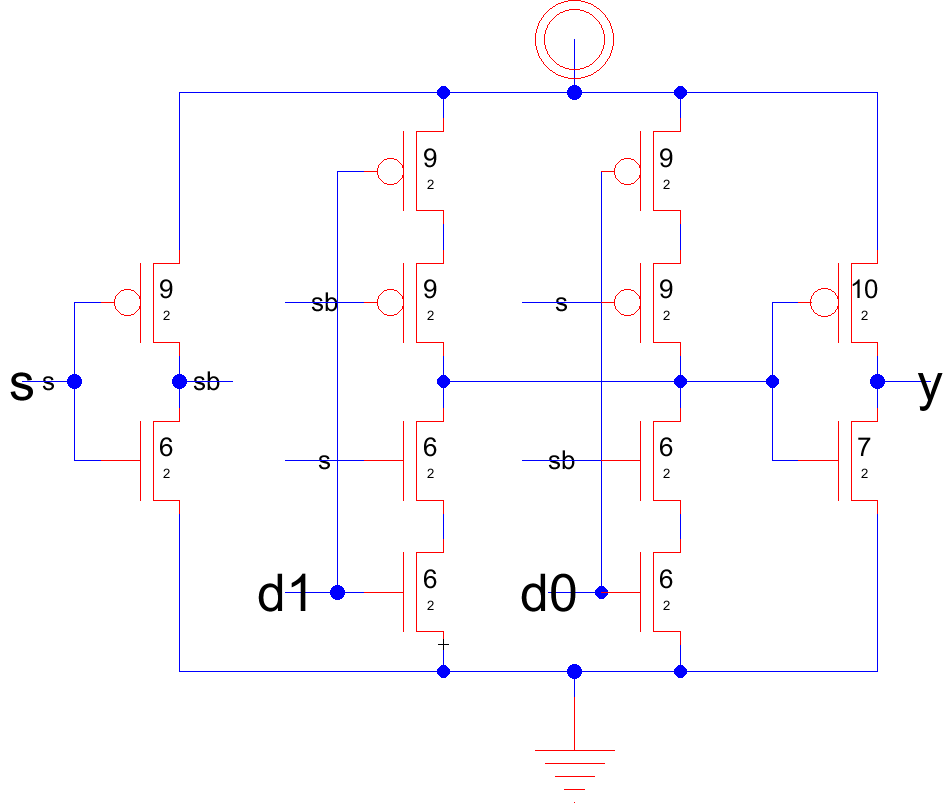
[picture p65: figure]

MUX6

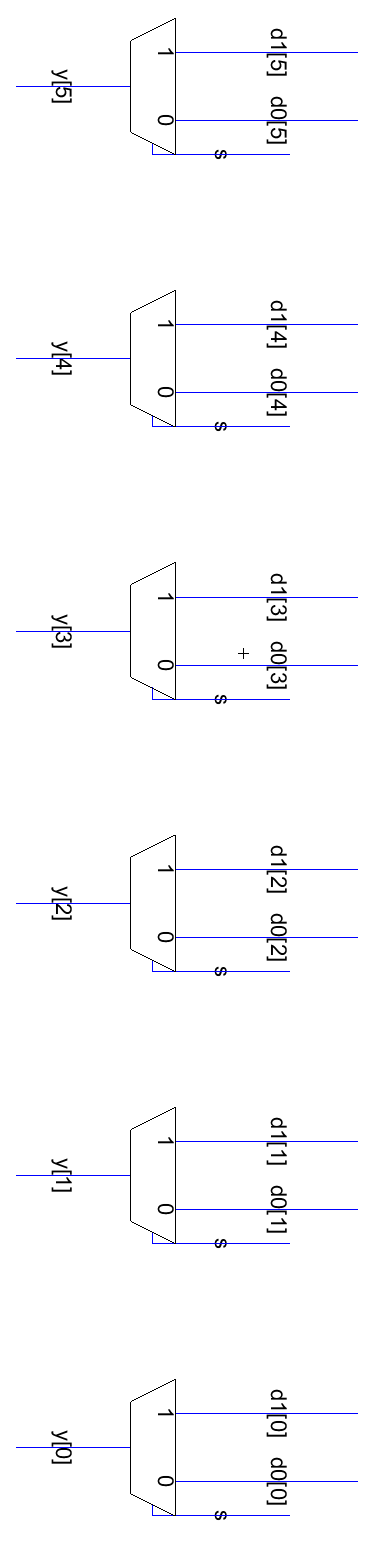
[picture p66: figure]

Xor2_1x

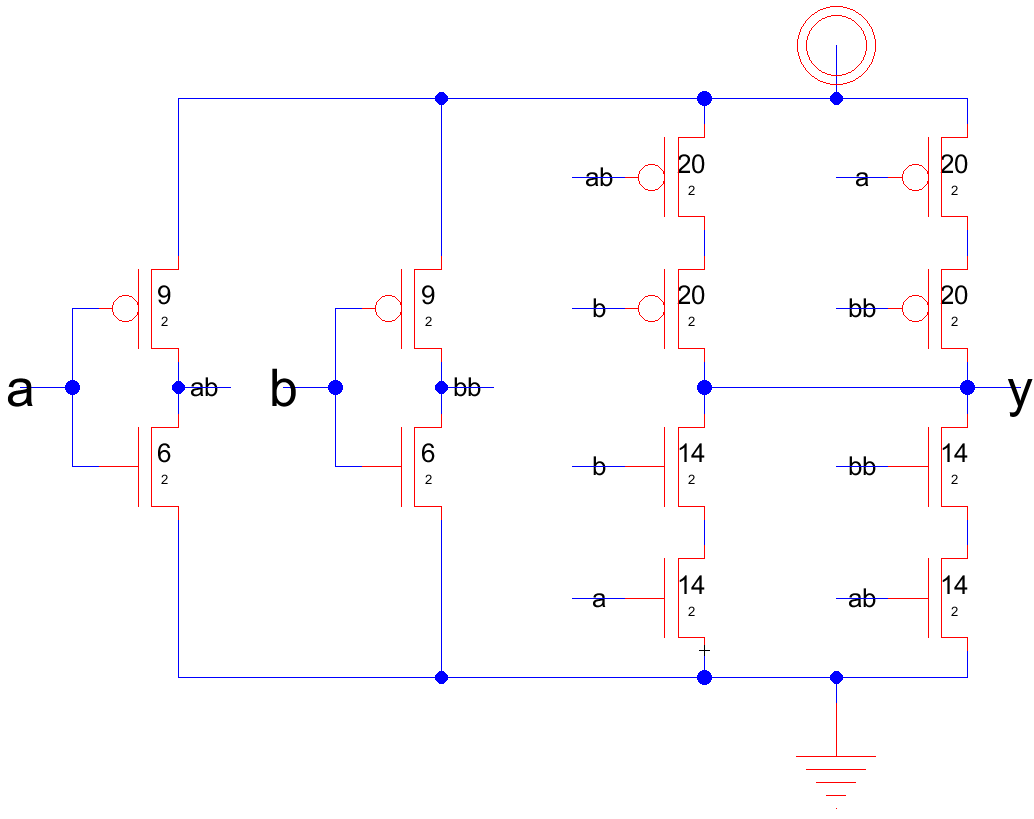
[picture p67: figure]
