xiaoqing1993/ECSE548_viterbi_decoder/C/OurFirstPlot.png

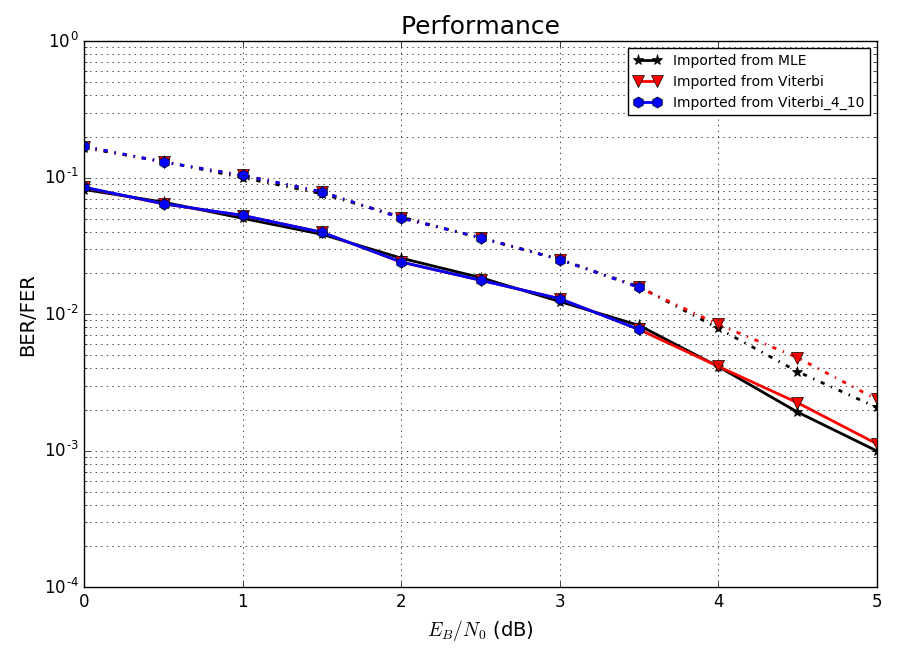
C/OurFirstPlot.png
