xiaoqing1993/ECSE548_viterbi_decoder/C/plots/choosing_floating_point_quantization_for_hardware.png

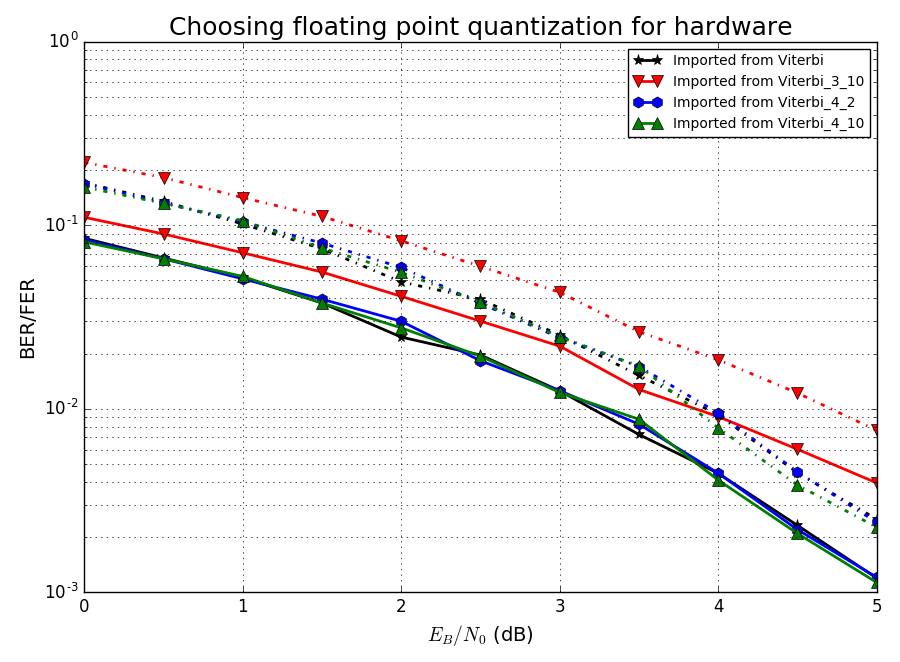
C/plots/choosing_floating_point_quantization_for_hardware.png
