xiaoqing1993/ECSE548_viterbi_decoder/C/plots/comparison_of_viterbi_decoder_with_mle_decoder.png

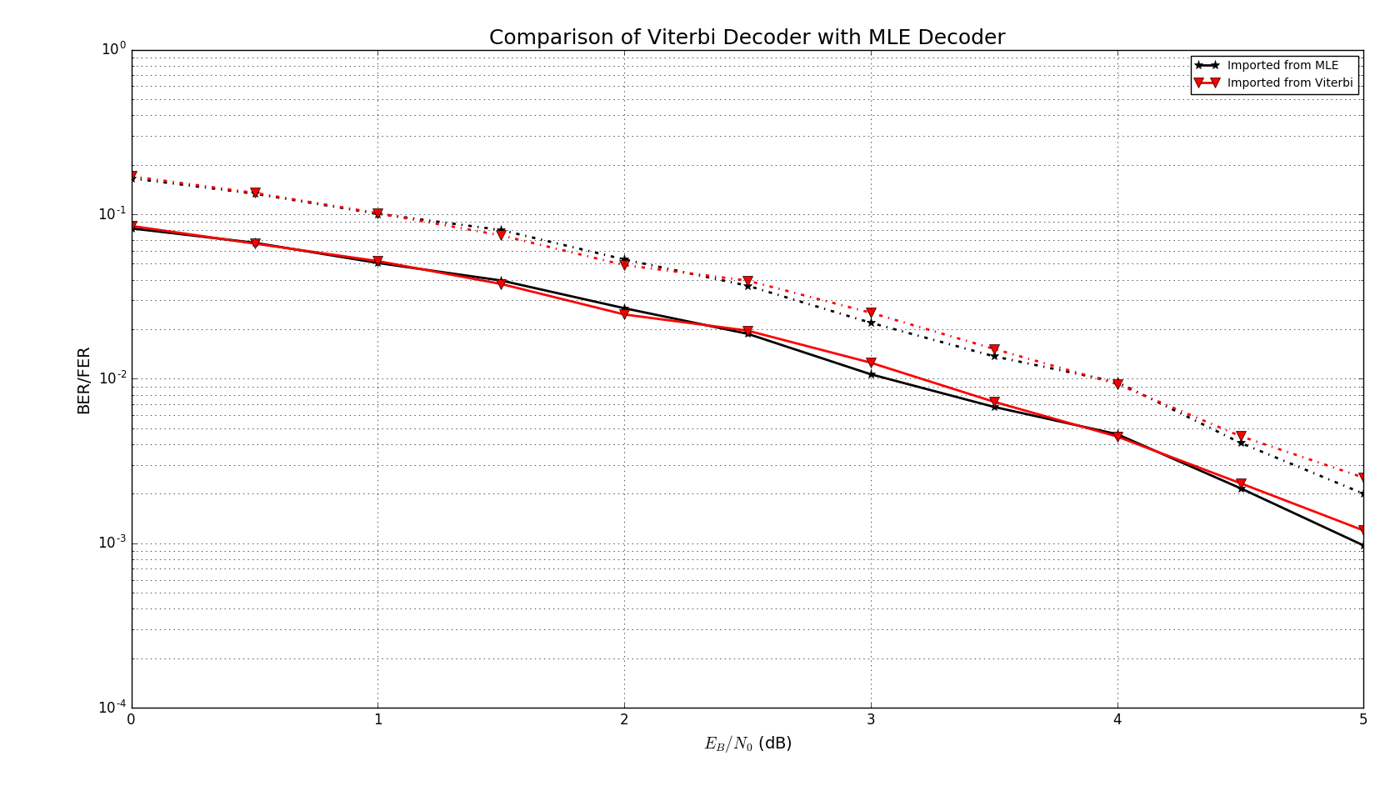
C/plots/comparison_of_viterbi_decoder_with_mle_decoder.png
