xiaoqing1993/ECSE548_viterbi_decoder/IRSIM/Screenshots/IRSIM examle script.png

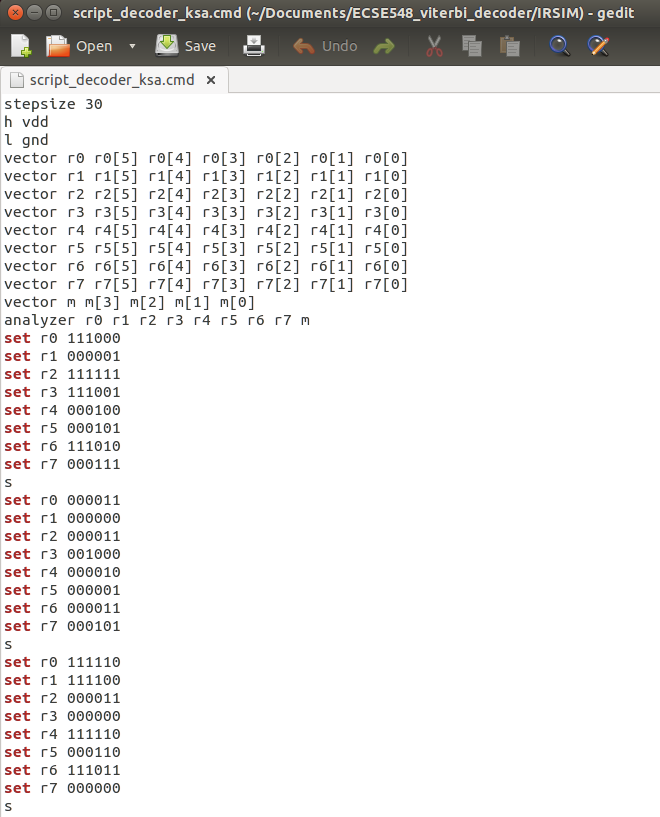
IRSIM/Screenshots/IRSIM examle script.png
