xiaoqing1993/ECSE548_viterbi_decoder/IRSIM/Screenshots/IRSIM_a2o1_38.59.png

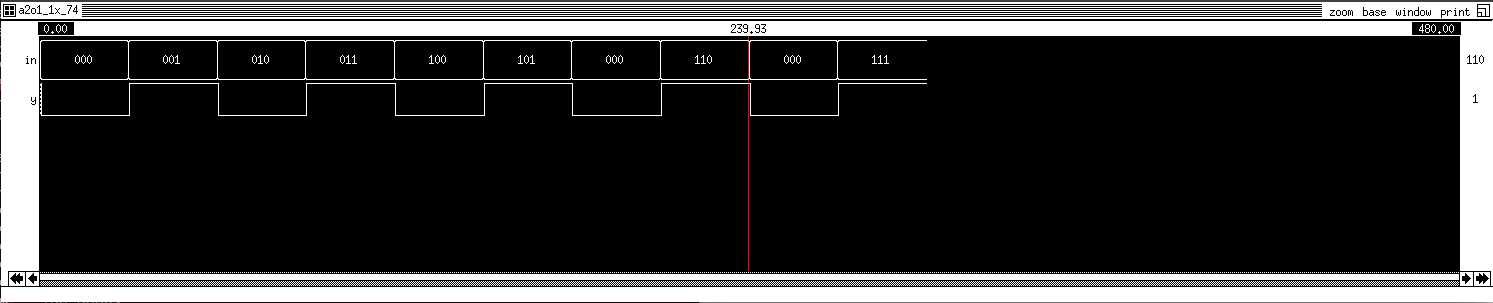
IRSIM/Screenshots/IRSIM_a2o1_38.59.png
