xiaoqing1993/ECSE548_viterbi_decoder/IRSIM/Screenshots/IRSIM_decoder1.png

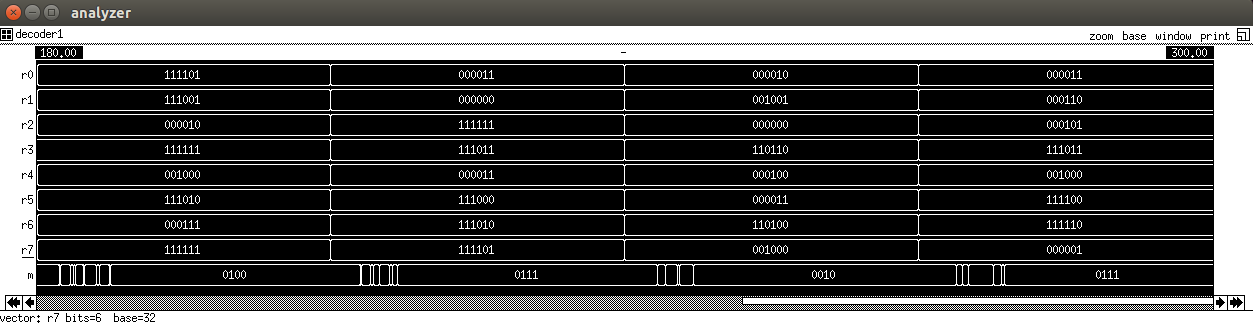
IRSIM/Screenshots/IRSIM_decoder1.png
