xiaoqing1993/ECSE548_viterbi_decoder/IRSIM/Screenshots/timing vector inputs.jpg

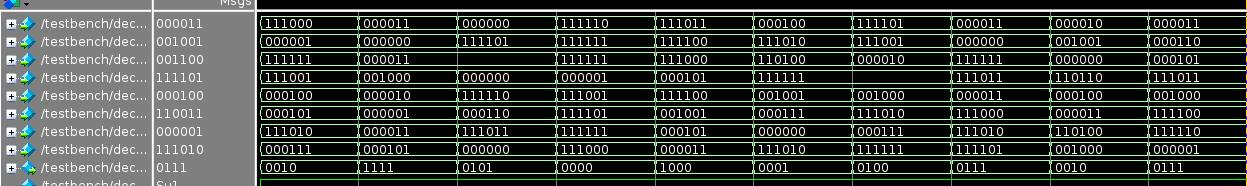
IRSIM/Screenshots/timing vector inputs.jpg
