xiaoqing1993/ECSE548_viterbi_decoder/Report_LatexSource/encode_trellis.png

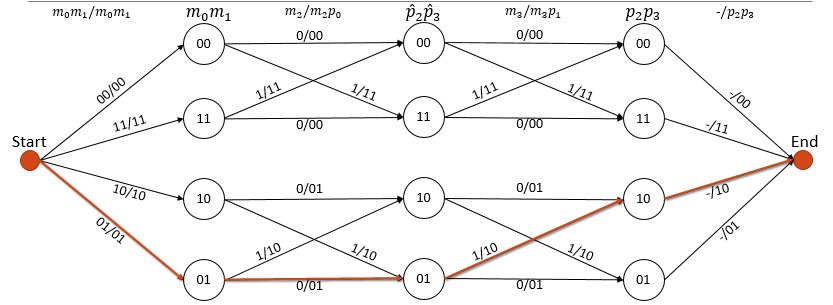
Report_LatexSource/encode_trellis.png
