xiaoqing1993/ECSE548_viterbi_decoder/Schematic Diagrams/Electric Schematics/fadd6.PNG

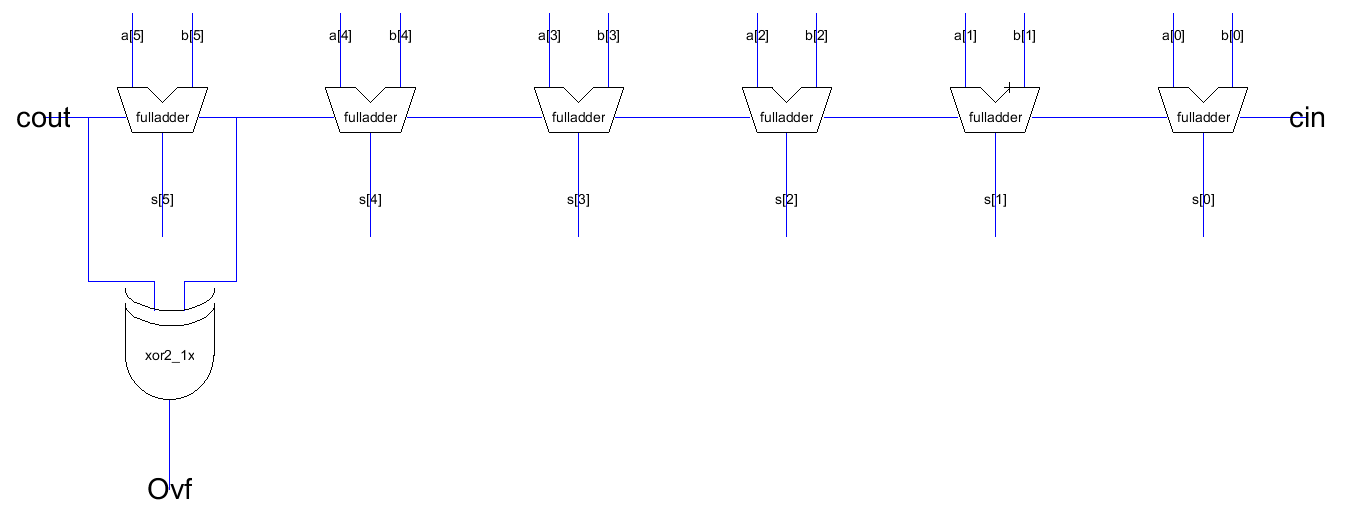
Schematic Diagrams/Electric Schematics/fadd6.PNG
