xiaoqing1993/ECSE548_viterbi_decoder/Schematic Diagrams/Electric Schematics/fulladder.PNG

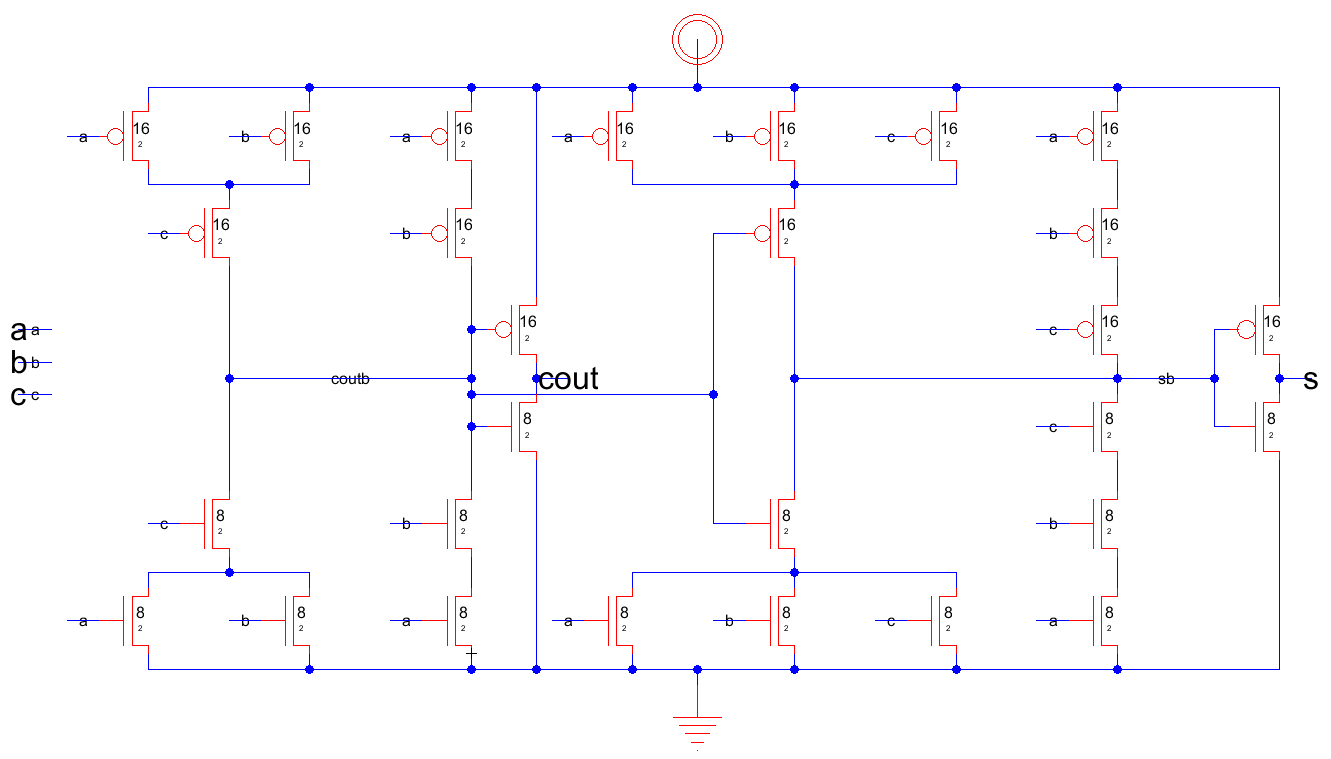
Schematic Diagrams/Electric Schematics/fulladder.PNG
