xiaoqing1993/ECSE548_viterbi_decoder/Schematic Diagrams/Electric Schematics/KS_comparator.PNG

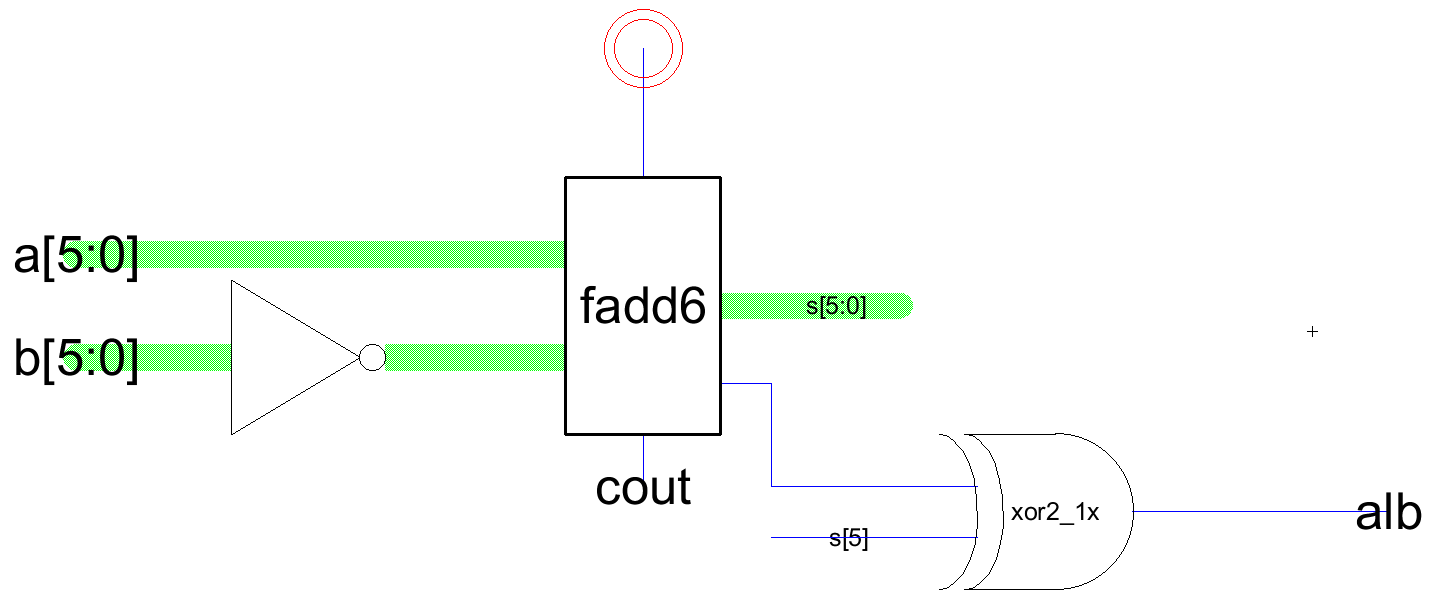
Schematic Diagrams/Electric Schematics/KS_comparator.PNG
