xiaoqing1993/ECSE548_viterbi_decoder/Schematic Diagrams/Electric Schematics/MUX6.PNG

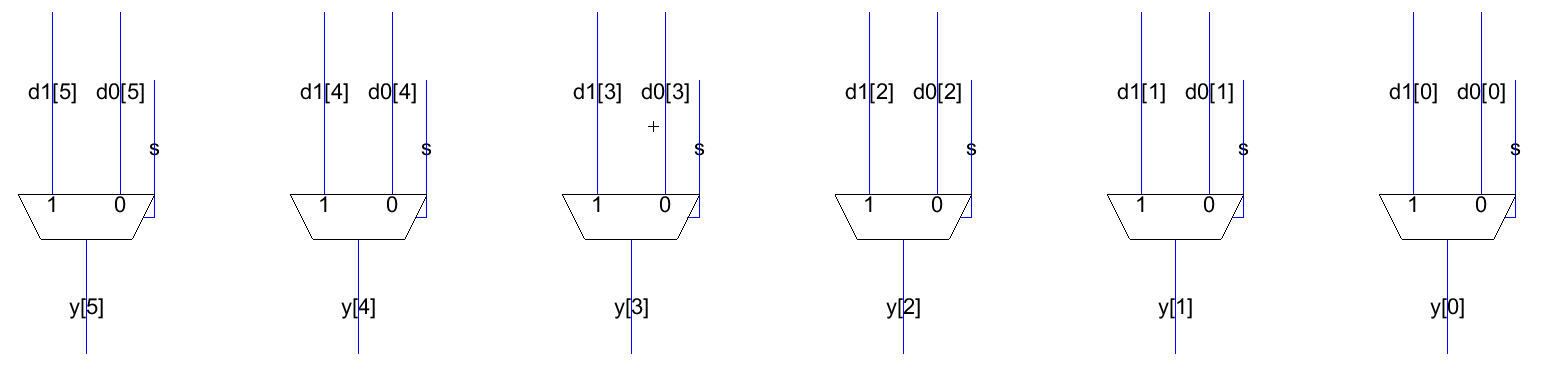
Schematic Diagrams/Electric Schematics/MUX6.PNG
