xiaoqing1993/ECSE548_viterbi_decoder/Schematic Diagrams/Presentation Diagrams/Screen Shot 2016-12-01 at 7.58.21 AM.png

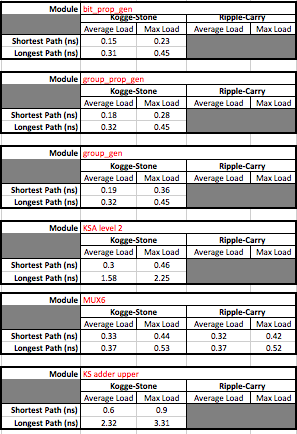
Schematic Diagrams/Presentation Diagrams/Screen Shot 2016-12-01 at 7.58.21 AM.png
