xiaoqing1993/ECSE548_viterbi_decoder/Schematic Diagrams/Shortest_Longest Path/bit_prop_gen.PNG

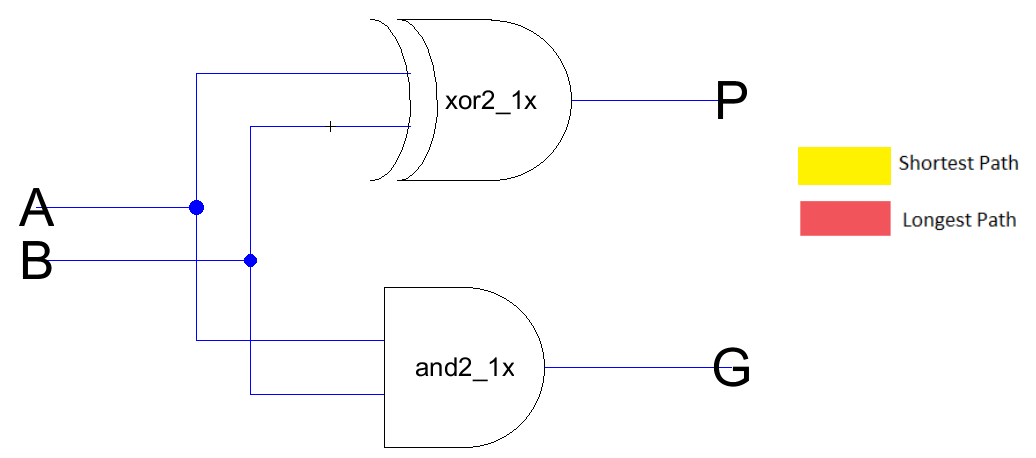
Schematic Diagrams/Shortest_Longest Path/bit_prop_gen.PNG
