xiaoqing1993/ECSE548_viterbi_decoder/Schematic Diagrams/Shortest_Longest Path/Carry_ripple_adder_2.png

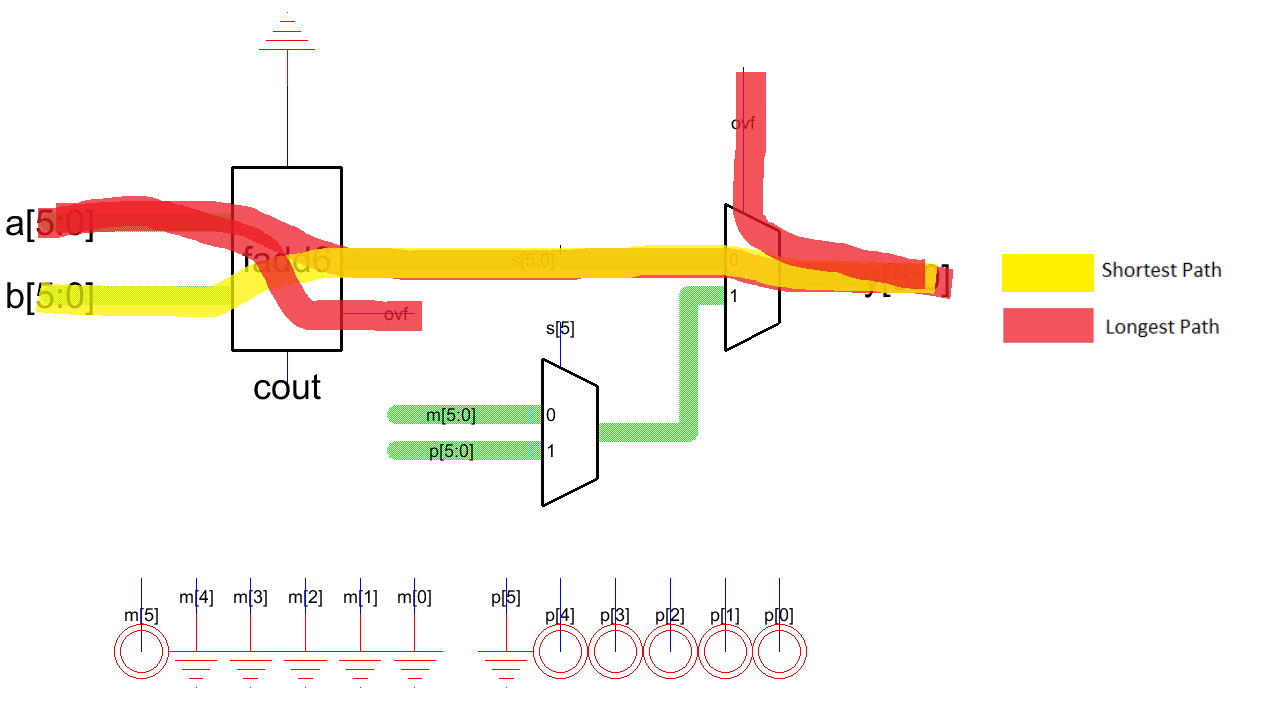
Schematic Diagrams/Shortest_Longest Path/Carry_ripple_adder_2.png
