xiaoqing1993/ECSE548_viterbi_decoder/Schematic Diagrams/Shortest_Longest Path/fadd6.PNG

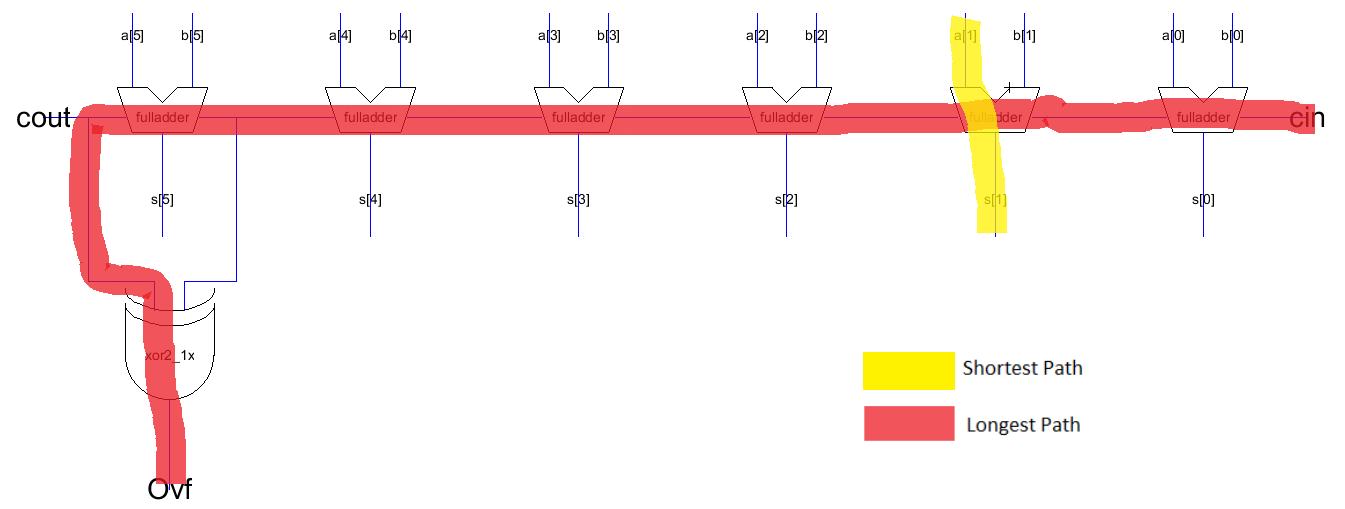
Schematic Diagrams/Shortest_Longest Path/fadd6.PNG
