xiaoqing1993/ECSE548_viterbi_decoder/Schematic Diagrams/Shortest_Longest Path/KS_comparator.PNG

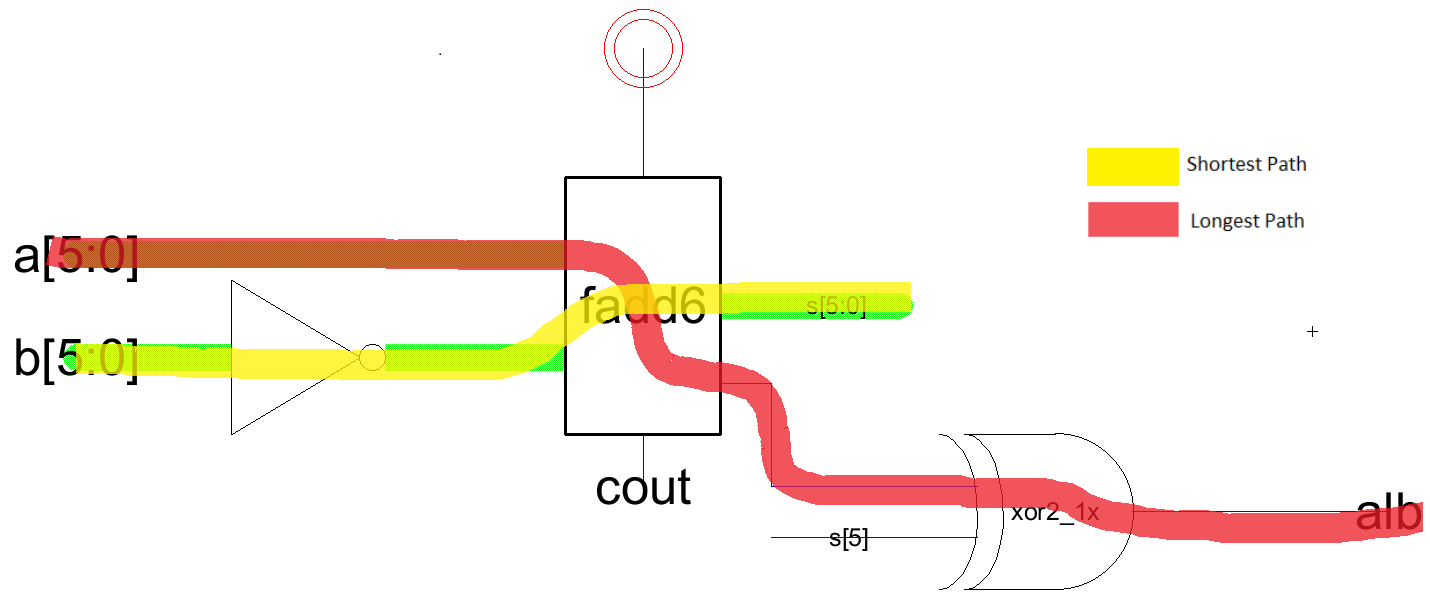
Schematic Diagrams/Shortest_Longest Path/KS_comparator.PNG
