xiaoqing1993/ECSE548_viterbi_decoder/Schematic Diagrams/Shortest_Longest Path/KSA level 2.PNG

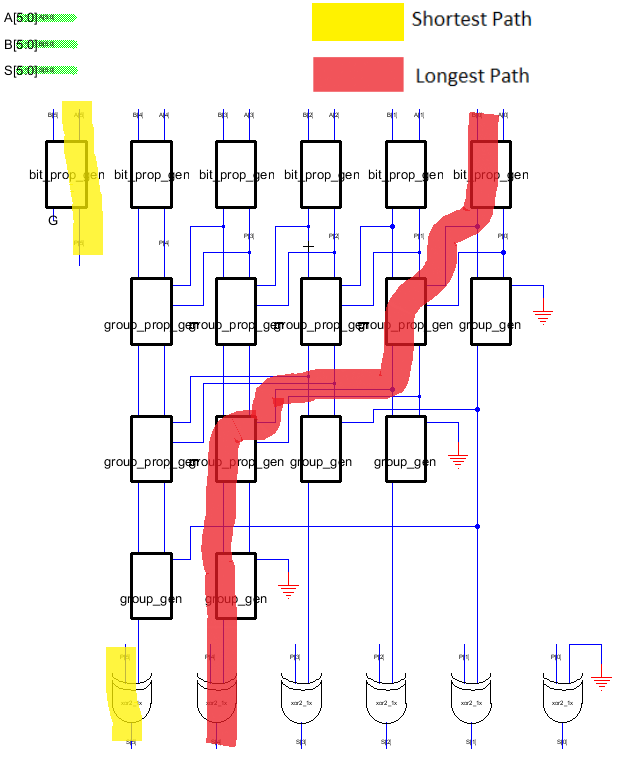
Schematic Diagrams/Shortest_Longest Path/KSA level 2.PNG
