xiaoqing1993/ECSE548_viterbi_decoder/Input Capacitance.xlsx

INPUT CAPACITANCE Spreadsheet
Purpose: This spreadsheet is used in the calculation of average input capacitance to load the circuit when testing the power.
Total width: Sumof width of allatatched transistors; Total Capacitance: Total width*0.3um*2fF/um; Average = AVG(Total Capacitance); Worst case = MAX(Total Capacitance)
Module | a201_1x |  |  |  |  |  |  |  |  | Total Gate Input Capacitance (fF) | 27 | KSA decoder
Input | Total Width | Total Capacitance (fF) | Average Input Capacitance (fF) | Worst Case Input Capacitance (fF) | Output | Total Width | Total Capacitance (fF) | Average Capacitance (fF) | Worst Case Capacitance (fF) | Total Gate Output Capacitance (fF)
a | 15 | 9 | 9 | 9 | y | 17 | 10.2 | 10.2 | 10.2 |  |  | Weighted Average input load/bit (fF) | 38.59338462 | Weighted average output load/bit (fF) | 11.86442966 | Weighted average total load/bit (fF) | 50.45781427
b | 15 | 9 |  |  |  |  |  |  |  |  |  | Weighted Max input load/bit (fF) | 74.01392308 | Weighted max output load/bit (fF) | 13.18631179 | Weighted max total load/bit (fF) | 87.20023486
c | 15 | 9 |  |  |  |  |  |  |  |  |  | RC decoder
Module | and2_1x |  |  |  |  |  |  |  |  |  |  | Weighted Average input load/bit (fF) | 36.52892308 | Weighted average output load/bit (fF) | 12.21517794 | Weighted average total load/bit (fF) | 48.74410101
Input | Total Width | Total Capacitance (fF) | Average Input Capacitance (fF) | Worst Case Input Capacitance (fF) | Output | Total Width | Total Capacitance (fF) | Average Capacitance (fF) | Worst Case Capacitance (fF) | Total Gate Input Capacitance (fF) | 1.44 | Weighted Max input load/bit (fF) | 68.68869231 | Weighted max output load/bit (fF) | 16.19658363 | Weighted max total load/bit (fF) | 84.88527594
a | 12 | 0.72 | 0.72 | 0.72 | y | 17 | 10.2 | 10.2 | 10.2 | Total Gate Output Capacitance (fF)
b | 12 | 0.72
Module | and3_1x |  |  |  |  |  |  |  |  | Total Gate Input Capacitance (fF) | 25.2
Input | Total Width | Total Capacitance (fF) | Average Input Capacitance (fF) | Worst Case Input Capacitance (fF) | Output | Total Width | Total Capacitance (fF) | Average Capacitance (fF) | Worst Case Capacitance (fF) | Total Gate Output Capacitance (fF)
a | 14 | 8.4 | 8.4 | 8.4 | y | 17 | 10.2 | 10.2 | 10.2
b | 14 | 8.4
c | 14 | 8.4
Module | fulladder |  |  |  |  |  |  |  |  | Total Gate Input Capacitance (fF) | 158.4
Input | Total Width | Total Capacitance (fF) | Average Input Capacitance (fF) | Worst Case Input Capacitance (fF) | Output | Total Width | Total Capacitance (fF) | Average Capacitance (fF) | Worst Case Capacitance (fF) | Total Gate Output Capacitance (fF)
a | 96 | 57.6 | 52.8 | 57.6 | Cout | 24 | 14.4 | 14.4 | 14.4
b | 96 | 57.6 |  |  | s | 24 | 14.4
c | 72 | 43.2
Module | inverter |  |  |  |  |  |  |  |  | Total Gate Input Capacitance (fF) | 1.02
Input | Total Width | Total Capacitance (fF) | Average Input Capacitance (fF) | Worst Case Input Capacitance (fF) | Output | Total Width | Total Capacitance (fF) | Average Capacitance (fF) | Worst Case Capacitance (fF) | Total Gate Output Capacitance (fF)
a | 17 | 1.02 | 1.02 | 1.02 | y | 17 | 10.2 | 10.2 | 10.2
Module | MUX2 |  |  |  |  |  |  |  |  | Total Gate Input Capacitance (fF) | 37.2
Input | Total Width | Total Capacitance (fF) | Average Input Capacitance (fF) | Worst Case Input Capacitance (fF) | Output | Total Width | Total Capacitance (fF) | Average Capacitance (fF) | Worst Case Capacitance (fF) | Total Gate Output Capacitance (fF)
s | 32 | 19.2 | 12.4 | 19.2 | y | 17 | 10.2 | 10.2 | 10.2
D0 | 15 | 9
D1 | 15 | 9
Module | xor2_1x |  |  |  |  |  |  |  |  | Total Gate Input Capacitance (fF) | 5.88
Input | Total Width | Total Capacitance (fF) | Average Input Capacitance (fF) | Worst Case Input Capacitance (fF) | Output | Total Width | Total Capacitance (fF) | Average Capacitance (fF) | Worst Case Capacitance (fF) | Total Gate Output Capacitance (fF)
a | 49 | 2.94 | 2.94 | 2.94 | y | 34 | 20.4 | 20.4 | 20.4
b | 49 | 2.94
Module | bit_prop_gen |  |  |  |  |  |  |  |  | Total Gate Input Capacitance (fF) | 122
Input | Total Width | Total Capacitance (fF) | Average Input Capacitance (fF) | Worst Case Input Capacitance (fF) | Output | Total Width | Total Capacitance (fF) | Average Capacitance (fF) | Worst Case Capacitance (fF) | Total Gate Output Capacitance (fF)
a |  | 61 | 61 | 61 | p |  | 20.4 | 15.3 | 20.4
b |  | 61 |  |  | g |  | 10.2
Module | group_gen |  |  |  |  |  |  |  |  | Total Gate Input Capacitance (fF) | 27
Input | Total Width | Total Capacitance (fF) | Average Input Capacitance (fF) | Worst Case Input Capacitance (fF) | Output | Total Width | Total Capacitance (fF) | Average Capacitance (fF) | Worst Case Capacitance (fF) | Total Gate Output Capacitance (fF)
G0 |  | 9 | 9 | 9 | y |  | 10.2 | 10.2 | 10.2
G1 |  | 9
P1 |  | 9
Module | group_prop_gen |  |  |  |  |  |  |  |  | Total Gate Input Capacitance (fF) | 28.44
Input | Total Width | Total Capacitance (fF) | Average Input Capacitance (fF) | Worst Case Input Capacitance (fF) | Output | Total Width | Total Capacitance (fF) | Average Capacitance (fF) | Worst Case Capacitance (fF) | Total Gate Output Capacitance (fF)
G0 |  | 9 | 7.11 | 9.72 | G2 |  | 10.2 | 10.2 | 10.2
G1 |  | 9 |  |  | P2 |  | 10.2
P0 |  | 0.72
P1 |  | 9.72
Module | KSA |  |  |  |  |  |  |  |  | Total Gate Input Capacitance (fF) | 732
Input | Total Width | Total Capacitance (fF) | Average Input Capacitance (fF) | Worst Case Input Capacitance (fF) | Output | Total Width | Total Capacitance (fF) | Average Capacitance (fF) | Worst Case Capacitance (fF) | Total Gate Output Capacitance (fF)
A[0] |  | 61 | 61 | 61 | S[0] |  | 20.4 | 20.4 | 20.4
A[1] |  | 61 |  |  | S[1] |  | 20.4
A[2] |  | 61 |  |  | S[2] |  | 20.4
A[3] |  | 61 |  |  | S[3] |  | 20.4
A[4] |  | 61 |  |  | S[4] |  | 20.4
A[5] |  | 61 |  |  | S[5] |  | 20.4
B[0] |  | 61
B[1] |  | 61
B[2] |  | 61
B[3] |  | 61
B[4] |  | 61
B[5] |  | 61
Module | MUX6 |  |  |  |  |  |  |  |  | Total Gate Input Capacitance (fF) | 223.2
Input | Total Width | Total Capacitance (fF) | Average Input Capacitance (fF) | Worst Case Input Capacitance (fF) | Output | Total Width | Total Capacitance (fF) | Average Capacitance (fF) | Worst Case Capacitance (fF) | Total Gate Output Capacitance (fF)
D0[0] |  | 9 | 17.16923077 | 115.2 | y[0] |  | 10.2 | 10.2 | 10.2
D0[1] |  | 9 |  |  | y[1] |  | 10.2
D0[2] |  | 9 |  |  | y[2] |  | 10.2
D0[3] |  | 9 |  |  | y[3] |  | 10.2
D0[4] |  | 9 |  |  | y[4] |  | 10.2
D0[5] |  | 9 |  |  | y[5] |  | 10.2
D1[0] |  | 9
D1[1] |  | 9
D1[2] |  | 9
D1[3] |  | 9
D1[4] |  | 9
D1[5] |  | 9
s |  | 115.2
Module | KSA adder upper |  |  |  |  |  |  |  |  | Total Gate Input Capacitance (fF) | 750.84
Input | Total Width | Total Capacitance (fF) | Average Input Capacitance (fF) | Worst Case Input Capacitance (fF) | Output | Total Width | Total Capacitance (fF) | Average Capacitance (fF) | Worst Case Capacitance (fF) | Total Gate Output Capacitance (fF)
A[0] |  | 61 | 62.57 | 70.42 | y[0] |  | 10.2 | 10.2 | 10.2
A[1] |  | 61 |  |  | y[1] |  | 10.2
A[2] |  | 61 |  |  | y[2] |  | 10.2
A[3] |  | 61 |  |  | y[3] |  | 10.2
A[4] |  | 61 |  |  | y[4] |  | 10.2
A[5] |  | 70.42 |  |  | y[5] |  | 10.2
B[0] |  | 61
B[1] |  | 61
B[2] |  | 61
B[3] |  | 61
B[4] |  | 61
B[5] |  | 70.42
Module | fadd6 |  |  |  |  |  |  |  |  | Total Gate Input Capacitance (fF) | 734.4
Input | Total Width | Total Capacitance (fF) | Average Input Capacitance (fF) | Worst Case Input Capacitance (fF) | Output | Total Width | Total Capacitance (fF) | Average Capacitance (fF) | Worst Case Capacitance (fF) | Total Gate Output Capacitance (fF)
A[0] |  | 57.6 | 56.49230769 | 57.6 | S[0] |  | 14.4 | 15.5175 | 20.4
A[1] |  | 57.6 |  |  | S[1] |  | 14.4
A[2] |  | 57.6 |  |  | S[2] |  | 14.4
A[3] |  | 57.6 |  |  | S[3] |  | 14.4
A[4] |  | 57.6 |  |  | S[4] |  | 14.4
A[5] |  | 57.6 |  |  | S[5] |  | 14.4
B[0] |  | 57.6 |  |  | cout |  | 17.34
B[1] |  | 57.6 |  |  | Ovf |  | 20.4
B[2] |  | 57.6
B[3] |  | 57.6
B[4] |  | 57.6
B[5] |  | 57.6
cin |  | 43.2
Module | KSA_comparator |  |  |  |  |  |  |  |  | Total Gate Input Capacitance (fF) | 351.72
Input | Total Width | Total Capacitance (fF) | Average Input Capacitance (fF) | Worst Case Input Capacitance (fF) | Output | Total Width | Total Capacitance (fF) | Average Capacitance (fF) | Worst Case Capacitance (fF) | Total Gate Output Capacitance (fF)
A[0] |  | 57.6 | 29.31 | 57.6 | S[0] |  | 14.4 | 15.885 | 20.4
A[1] |  | 57.6 |  |  | S[1] |  | 14.4
A[2] |  | 57.6 |  |  | S[2] |  | 14.4
A[3] |  | 57.6 |  |  | S[3] |  | 14.4
A[4] |  | 57.6 |  |  | S[4] |  | 14.4
A[5] |  | 57.6 |  |  | S[5] |  | 17.34
B[0] |  | 1.02 |  |  | cout |  | 17.34
B[1] |  | 1.02 |  |  | alb |  | 20.4
B[2] |  | 1.02
B[3] |  | 1.02
B[4] |  | 1.02
B[5] |  | 1.02
Module | Carry ripple adder |  |  |  |  |  |  |  |  | Total Gate Input Capacitance (fF) | 691.2
Input | Total Width | Total Capacitance (fF) | Average Input Capacitance (fF) | Worst Case Input Capacitance (fF) | Output | Total Width | Total Capacitance (fF) | Average Capacitance (fF) | Worst Case Capacitance (fF) | Total Gate Output Capacitance (fF)
A[0] |  | 57.6 | 57.6 | 57.6 | S[0] |  | 10.2 | 11.22 | 17.34
A[1] |  | 57.6 |  |  | S[1] |  | 10.2
A[2] |  | 57.6 |  |  | S[2] |  | 10.2
A[3] |  | 57.6 |  |  | S[3] |  | 10.2
A[4] |  | 57.6 |  |  | S[4] |  | 10.2
A[5] |  | 57.6 |  |  | S[5] |  | 10.2
B[0] |  | 57.6 |  |  | cout |  | 17.34
B[1] |  | 57.6
B[2] |  | 57.6
B[3] |  | 57.6
B[4] |  | 57.6
B[5] |  | 57.6
Module | KSA top level |  |  |  |  |  |  |  |  | Total Gate Input Capacitance (fF) | 3003.36
Input | Total Width | Total Capacitance (fF) | Average Input Capacitance (fF) | Worst Case Input Capacitance (fF) | Output | Total Width | Total Capacitance (fF) | Average Capacitance (fF) | Worst Case Capacitance (fF) | Total Gate Output Capacitance (fF)
r0[0] |  | 61 | 62.57 | 70.42 | m[0] |  | 10.2 | 10.2 | 10.2
r0[1] |  | 61 |  |  | m[1] |  | 10.2
r0[2] |  | 61 |  |  | m[2] |  | 10.2
r0[3] |  | 61 |  |  | m[3] |  | 10.2
r0[4] |  | 61
r0[5] |  | 70.42
r1[0] |  | 61
r1[1] |  | 61
r1[2] |  | 61
r1[3] |  | 61
r1[4] |  | 61
r1[5] |  | 70.42
r2[0] |  | 61
r2[1] |  | 61
r2[2] |  | 61
r2[3] |  | 61
r2[4] |  | 61
r2[5] |  | 70.42
r3[0] |  | 61
r3[1] |  | 61
r3[2] |  | 61
r3[3] |  | 61
r3[4] |  | 61
r3[5] |  | 70.42
r4[0] |  | 61
r4[1] |  | 61
r4[2] |  | 61
r4[3] |  | 61
r4[4] |  | 61
r4[5] |  | 70.42
r5[0] |  | 61
r5[1] |  | 61
r5[2] |  | 61
r5[3] |  | 61
r5[4] |  | 61
r5[5] |  | 70.42
r6[0] |  | 61
r6[1] |  | 61
r6[2] |  | 61
r6[3] |  | 61
r6[4] |  | 61
r6[5] |  | 70.42
r7[0] |  | 61
r7[1] |  | 61
r7[2] |  | 61
r7[3] |  | 61
r7[4] |  | 61
r7[5] |  | 70.42
Module | RC top level |  |  |  |  |  |  |  |  | Total Gate Input Capacitance (fF) | 2764.8
Input | Total Width | Total Capacitance (fF) | Average Input Capacitance (fF) | Worst Case Input Capacitance (fF) | Output | Total Width | Total Capacitance (fF) | Average Capacitance (fF) | Worst Case Capacitance (fF) | Total Gate Output Capacitance (fF)
r0[0] |  | 57.6 | 57.6 | 57.6 | m[0] |  | 10.2 | 10.2 | 10.2
r0[1] |  | 57.6 |  |  | m[1] |  | 10.2
r0[2] |  | 57.6 |  |  | m[2] |  | 10.2
r0[3] |  | 57.6 |  |  | m[3] |  | 10.2
r0[4] |  | 57.6
r0[5] |  | 57.6
r1[0] |  | 57.6
r1[1] |  | 57.6
r1[2] |  | 57.6
r1[3] |  | 57.6
r1[4] |  | 57.6
r1[5] |  | 57.6
r2[0] |  | 57.6
r2[1] |  | 57.6
r2[2] |  | 57.6
r2[3] |  | 57.6
r2[4] |  | 57.6
r2[5] |  | 57.6
r3[0] |  | 57.6
r3[1] |  | 57.6
r3[2] |  | 57.6
r3[4] |  | 57.6
r3[4] |  | 57.6
r3[5] |  | 57.6
r4[0] |  | 57.6
r4[1] |  | 57.6
r4[2] |  | 57.6
r4[3] |  | 57.6
r4[4] |  | 57.6
r4[5] |  | 57.6
r5[0] |  | 57.6
r5[1] |  | 57.6
r5[2] |  | 57.6
r5[3] |  | 57.6
r5[4] |  | 57.6
r5[5] |  | 57.6
r6[0] |  | 57.6
r6[1] |  | 57.6
r6[2] |  | 57.6
r6[3] |  | 57.6
r6[4] |  | 57.6
r6[5] |  | 57.6
r7[0] |  | 57.6
r7[1] |  | 57.6
r7[2] |  | 57.6
r7[3] |  | 57.6
r7[4] |  | 57.6
r7[5] |  | 57.6
