xiaoqing1993/ECSE548_viterbi_decoder/(list of files, cad)

Other CAD files:
Kogge Stone Adder - VHDL/simulation/qsim/work/six_bit_kogge_stone_adder/verilog.psm
Kogge Stone Adder - VHDL/simulation/qsim/work/six_bit_kogge_stone_adder_vlg_check_tst/verilog.psm
Kogge Stone Adder - VHDL/simulation/qsim/work/six_bit_kogge_stone_adder_vlg_sample_tst/verilog.psm
Kogge Stone Adder - VHDL/simulation/qsim/work/six_bit_kogge_stone_adder_vlg_vec_tst/verilog.psm
