xiaoqing1993/ECSE548_viterbi_decoder/SPICE/CIR files/12 input stimulus.asc

R1: res; 10
R2: res; 10
R3: res; 10
R4: res; 10
R5: res; 10
R6: res; 10
R7: res; 10
R8: res; 10
R9: res; 10
R10: res; 10
R11: res; 10
R12: res; 10
V1: voltage; PULSE(0 3.3 100n 0.1n 0.1n 100n 200n 2056)
V2: voltage; PULSE(0 3.3 200n 0.1n 0.1n 200n 400n 1024)
V3: voltage; PULSE(0 3.3 400n 0.1n 0.1n 400n 800n 512)
V4: voltage; PULSE(0 3.3 800n 0.1n 0.1n 800n 1600n 256)
V5: voltage; PULSE(0 3.3 1600n 0.1n 0.1n 1600n 3200n 128)
V6: voltage; PULSE(0 3.3 3200n 0.1n 0.1n 3200n 6400n 64)
V7: voltage; PULSE(0 3.3 6400n 0.1n 0.1n 6400n 12800n 32)
V8: voltage; PULSE(0 3.3 12800n 0.1n 0.1n 12800n 25600n 16)
V9: voltage; PULSE(0 3.3 25600n 0.1n 0.1n 25600n 51200n 8)
V10: voltage; PULSE(0 3.3 51200n 0.1n 0.1n 51200n 102400n 4)
V11: voltage; PULSE(0 3.3 102400n 0.1n 0.1n 102400n 204800n 2)
V12: voltage; PULSE(0 3.3 204800n 0.1n 0.1n 204800n 409600n 1)
Named nets: 0
.tran 0 409600nS 0
