xiaoqing1993/ECSE548_viterbi_decoder/SPICE/CIR files/3 input stimulus.asc

R1: res; 10
R2: res; 10
R3: res; 10
V1: voltage; PULSE(0 3.3 100n 0.1n 0.1n 100n 200n 10)
V2: voltage; PULSE(0 3.3 200n 0.1n 0.1n 200n 400n 10)
V3: voltage; PULSE(0 3.3 400n 0.1n 0.1n 400n 800n 1)
Named nets: 0
.tran 0 800nS 0
