xiaoqing1993/ECSE548_viterbi_decoder/(commit log)

2016-11-24 Kogge Stone Adder verified in VHDL, now to build a schematic in Electric
    [verilog.psm]
2016-11-24 comparator schematic made
2016-11-24 comparator schematic made, hope the merge works
2016-11-24 Kogge Stone Adder Schematic
2016-11-24 working fixed point adder schematic
    [adder6_ksa_sch.v, testbench.sv]
2016-11-24 another working fixed point adder schematic (using ripple carry adder)
    [adder6_ksa_sch.v, adder6_sch.v]
2016-11-24 Started the decoder schematic
2016-11-26 slight update to decoder schematic
2016-11-26 decoder schematic complete
2016-12-01 adding IRSIM files
    [Input Capacitance.xlsx]
2016-12-06 add circuit simulation files and slides
    [Gate Delay.xlsx, Input Capacitance.xlsx]
