xiaoqing1993/ECSE548_viterbi_decoder/(notices)

Notices in the files:
Report_LatexSource/main.tex:
This work is distributed under the LaTeX Project Public License (LPPL)
